syurecat/cansat-2024/README.md

[日本語](README.md) | [English](README.en.md)
# Koshi Science Team 2024

## ミッション
### スバル計画(Sub-aru計画)
缶サットにおける親機、子機、地上間の通信技術の確立

## 構成
- 'Visualization/': データの保存、可視化を担うwebアプリ
- 'arduino/': arduinoのプログラム
- 'twalite/': twaliteのプログラム
- 'docs/': システムのドキュメント

## 使用方法
各ディレクトリ下にあるREADMEに従ってセットアップ

## 使用機材

## 注意すべき仕様
- VisualizationのFirefoxへの対応することは今のところ考えていません。
