syurecat/cansat-2024/docs/CanSatNationalsPrePresentation.pdf

## 福井県立高志高等学校 物理部

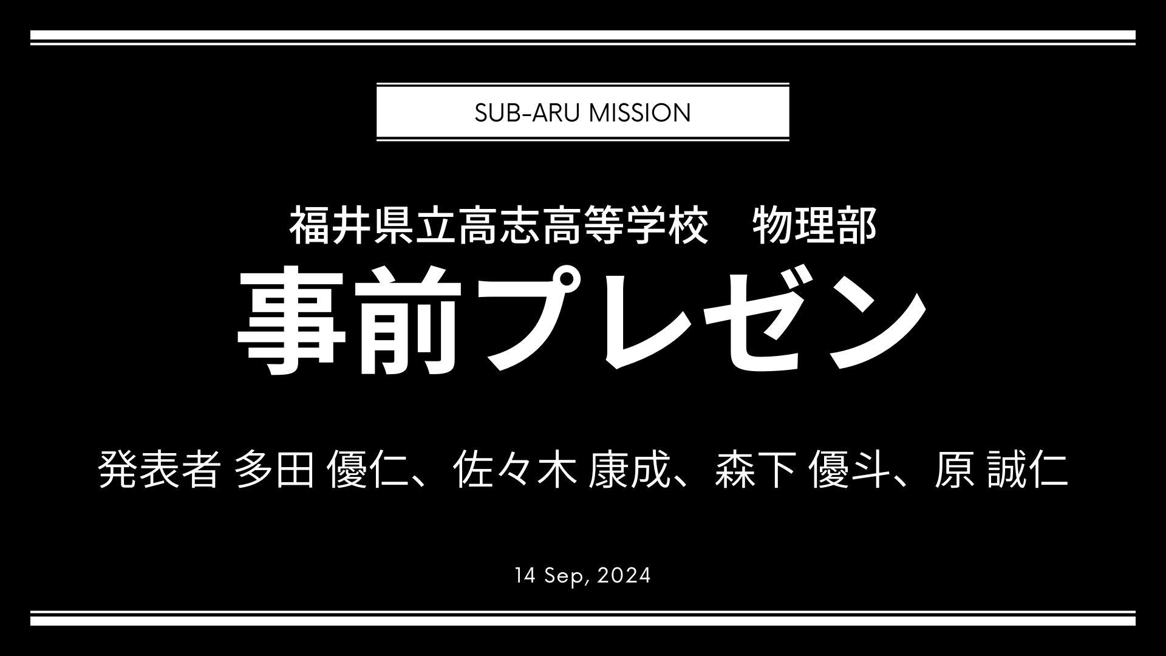
[picture p1: page 1]

福井県立高志高等学校　物理部

# 事前プレゼン

### 発表者 多田 優仁、佐々木 康成、 森下 優斗、原 誠仁

２０２４年度　缶サット福井県大会

目次

## 親機、子機、地上間の 通信技術の確立 情報のリアルタイム可視化

CONTENT 01 ミッション概要

CONTENT 01 ミッション概要
＊ミッションの目標

### 子機、親機、地上の双方向通信を確立する

# リアルタイムかつ高速に通信

### テレメトリデータの可視化

CONTENT 01 ミッション概要

＊ミッションの意義

１回収不可能なミッションにおいて通信は必須

２容量の大きなデータを送りやすい

３誰が見てもわかりやすく可視化できる

# 未知の惑星

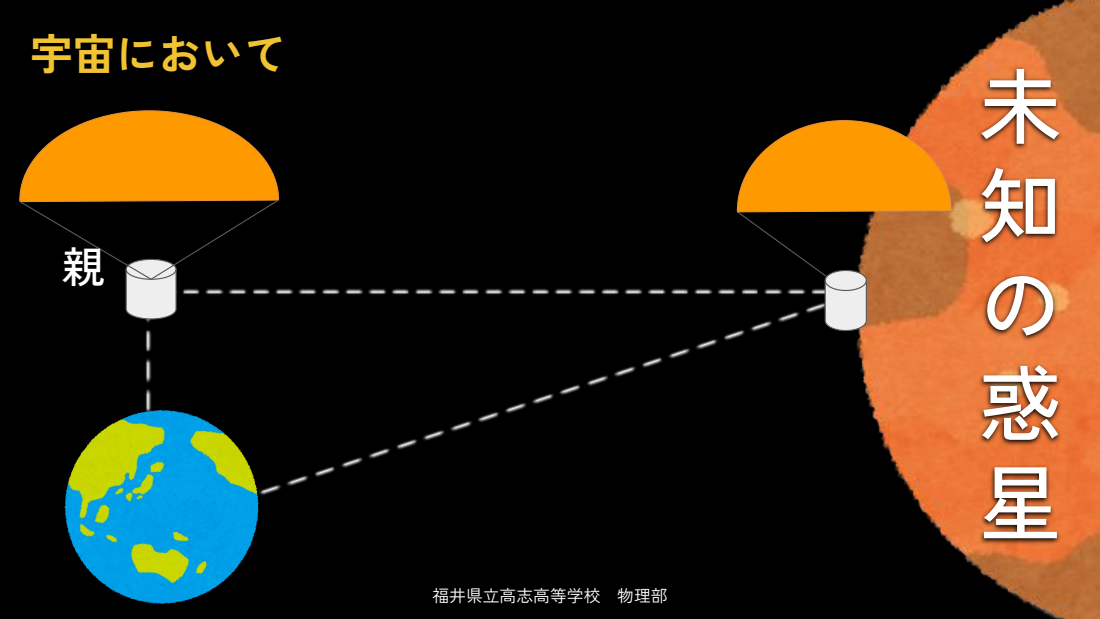
[picture p2: page 6]
宇宙において 親

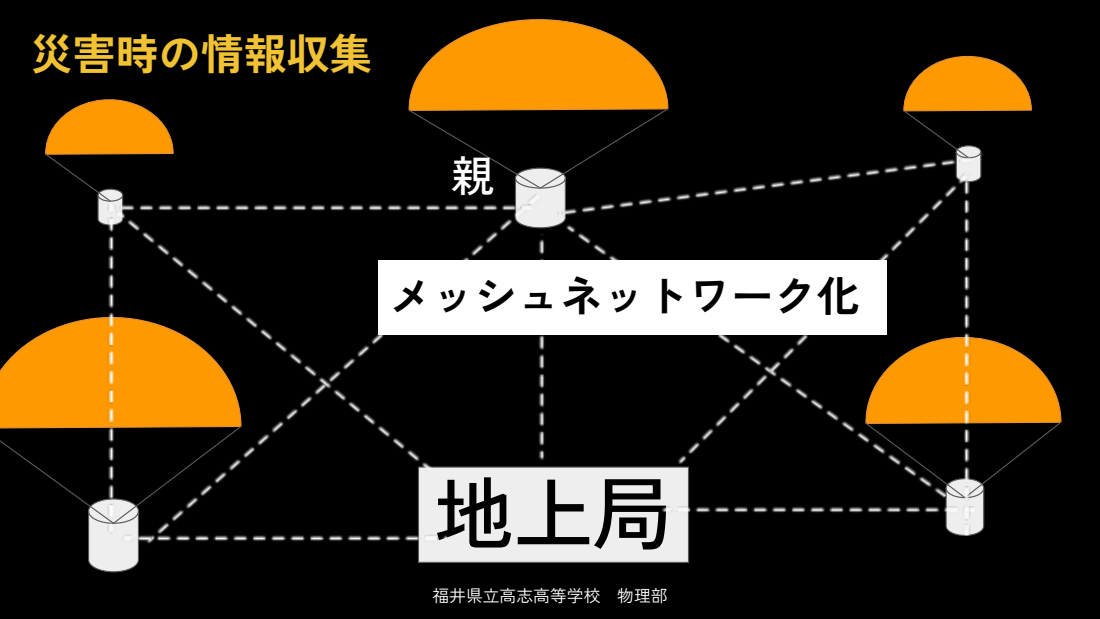
[picture p3: page 7]
地上局; 災害時の情報収集; メッシュネットワーク化

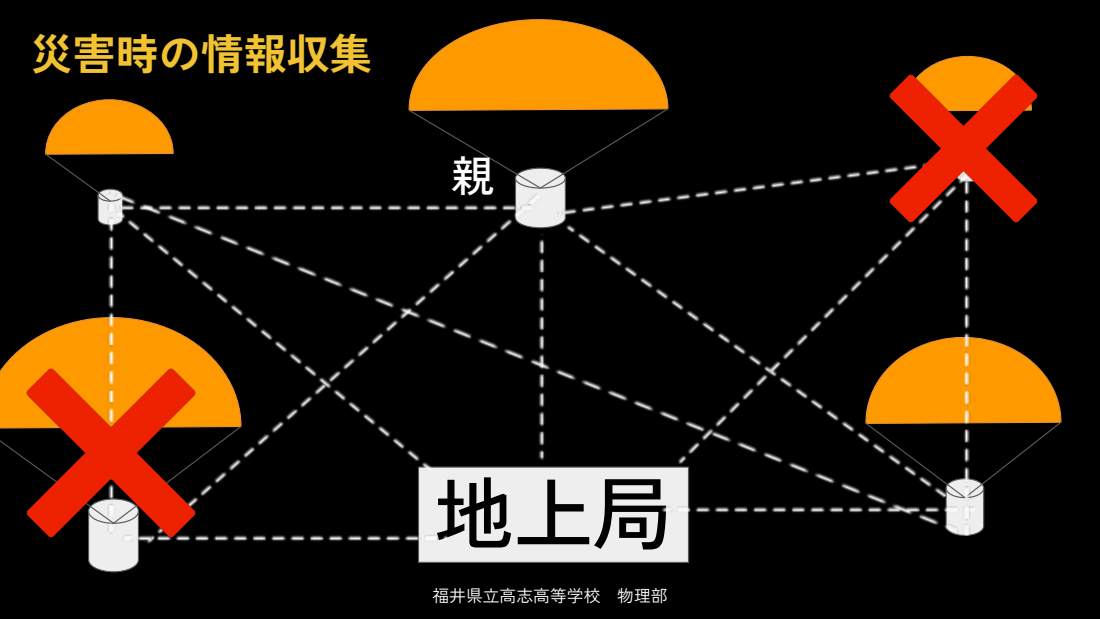
[picture p4: page 8]
地上局; 災害時の情報収集

情報をリアルタイムにグラフ化することによって...

１傾向、異常値の発見が早急にできる

２複雑なデータでも理解しやすい

３手順の統一化、効率化ができる

→原因分析、状況に応じた対応が取りやすい

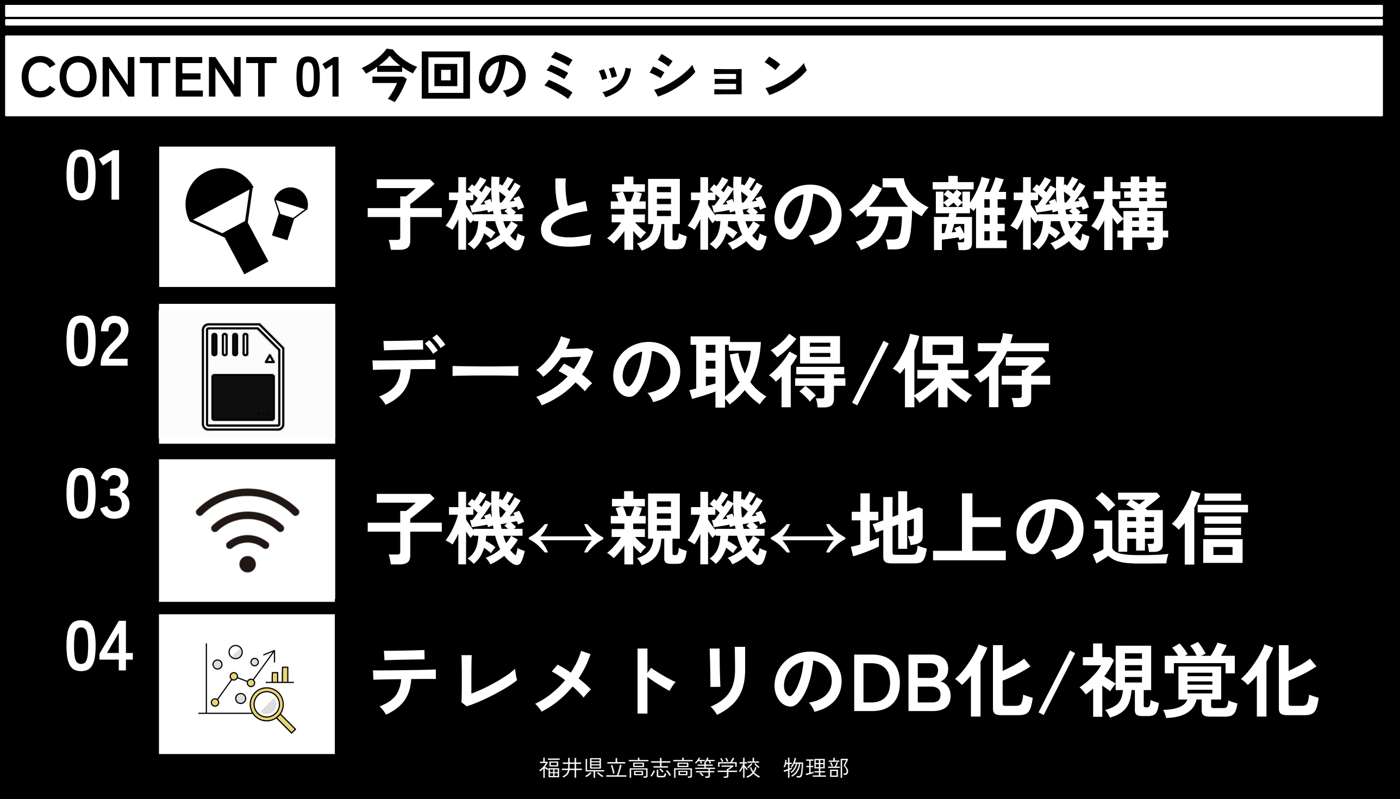
[picture p5: figure]
子機と親機の分離機構; データの取得/保存; 子機↔親機↔地上の通信 04 テレメトリのDB化/視覚化

CONTENT 01 ミッションに必要な3つの軸 CONTENT 01 今回のミッション

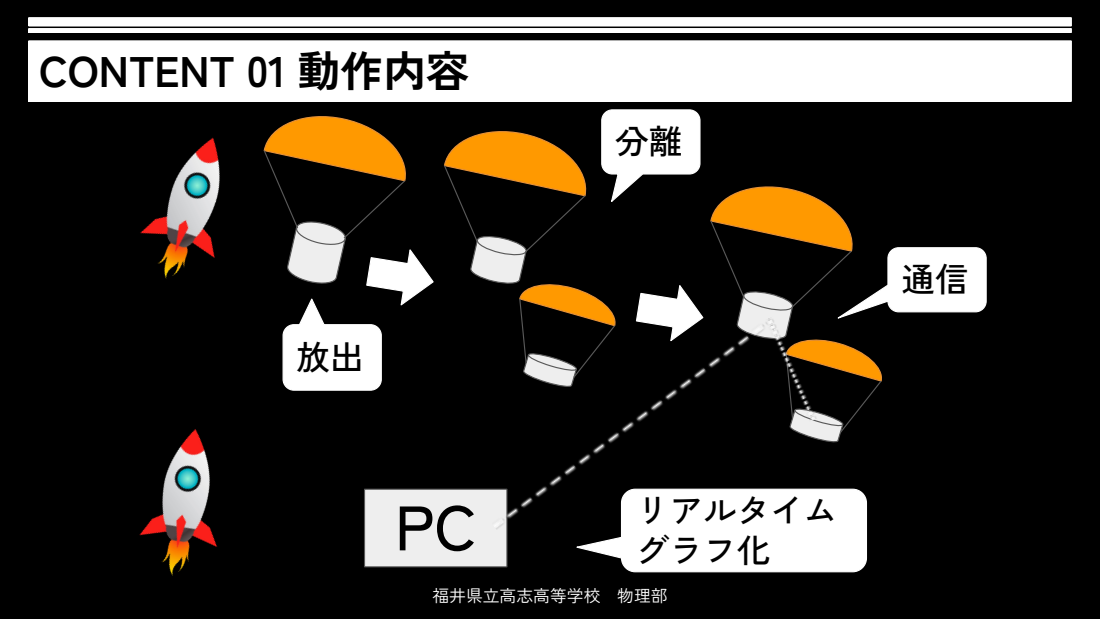
[picture p6: page 11]
リアルタイム; グラフ化

CONTENT 01 ミッションに必要な3つの軸 CONTENT 01 動作内容

CONTENT 01 ミッションに必要な3つの軸 CONTENT 缶サットの名称

# Sub-aru 計画

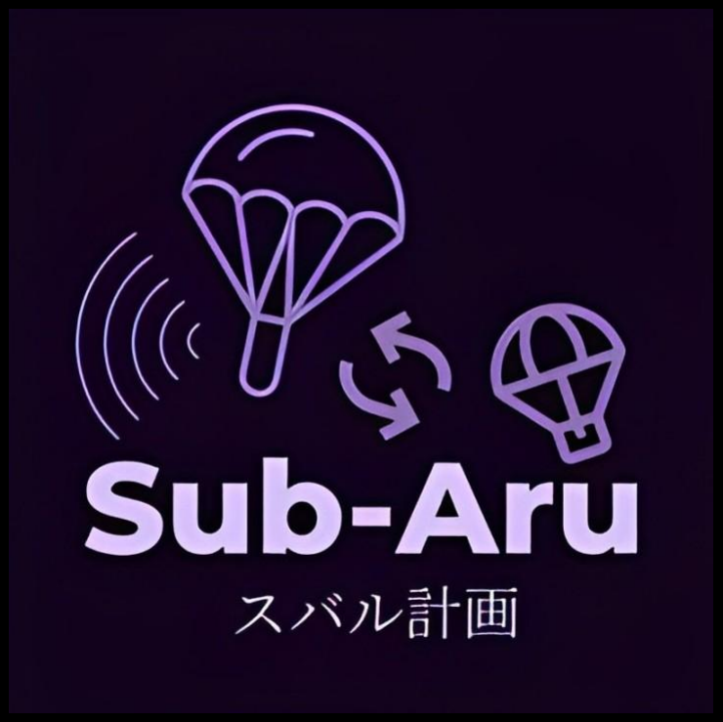
[picture p7: figure]

CONTENT 01 ミッションに必要な3つの軸 CONTENT 缶サットの名称

スバル 計画 | 機体　すばる君
| 親機　すばるマザー
| 子機　すばるキッズ

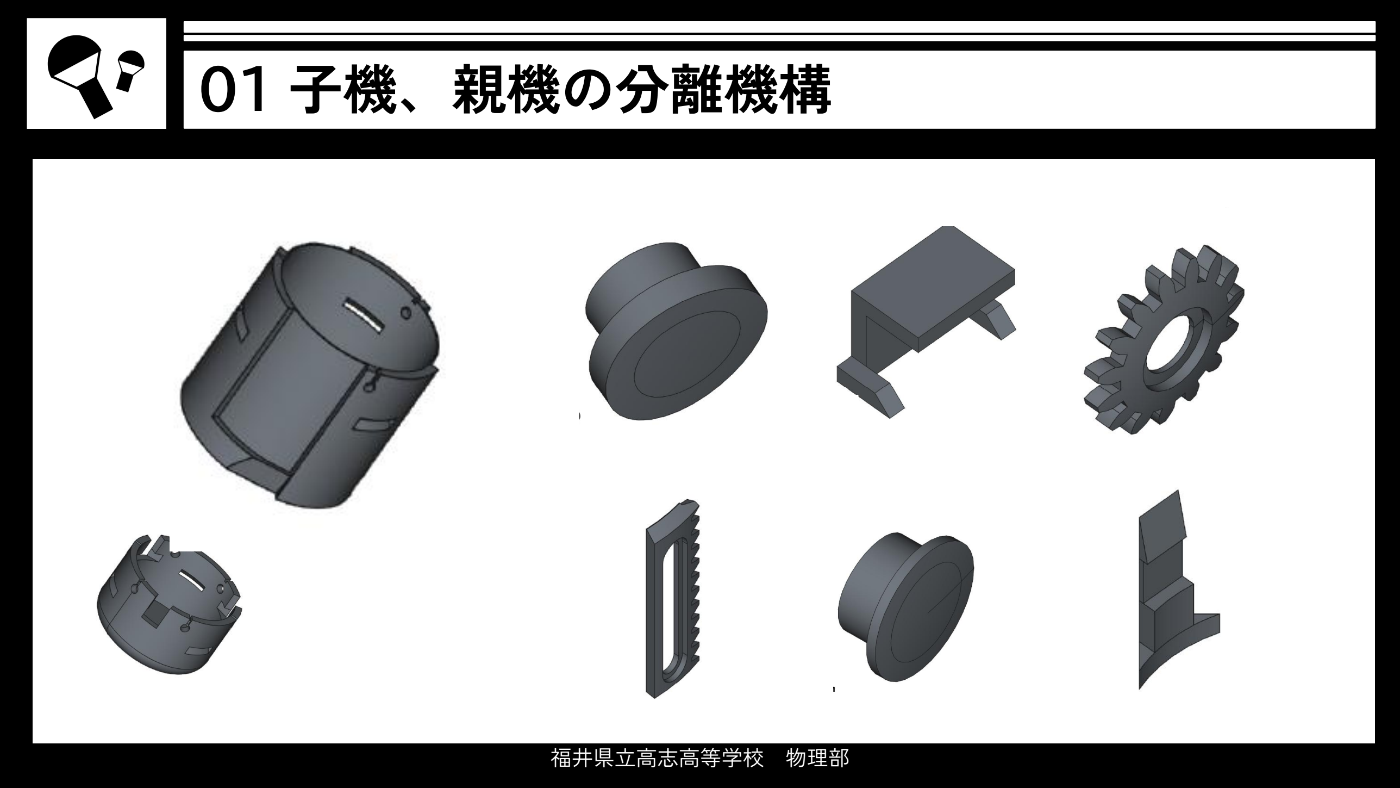
[picture p8: page 14]

CONTENT 01 ミッションに必要な3つの軸 01 子機、親機の分離機構

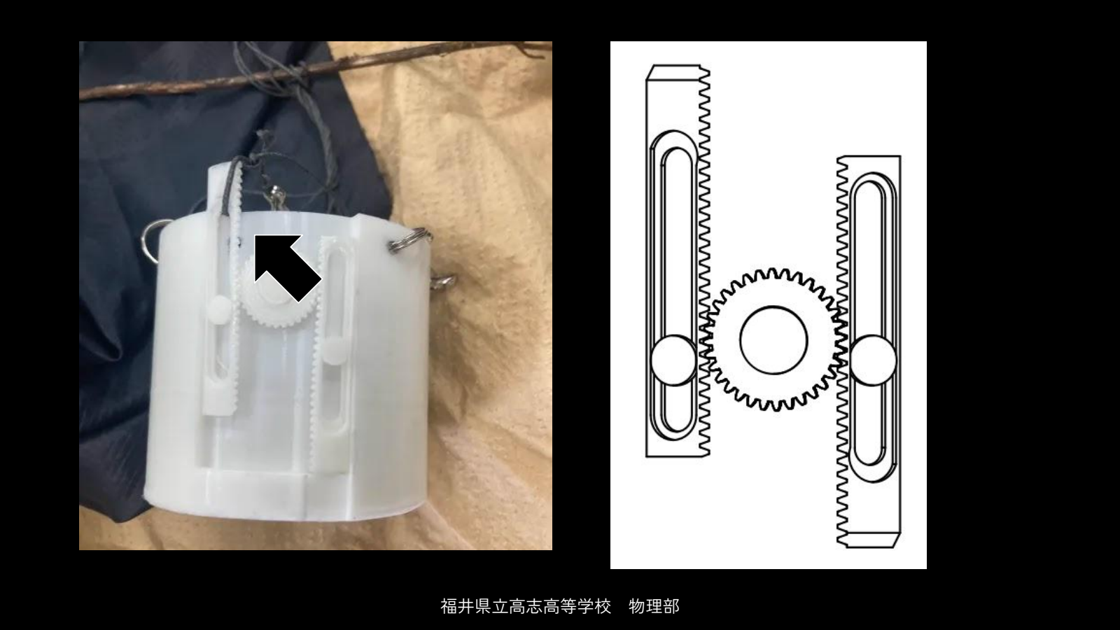
[picture p9: page 15]
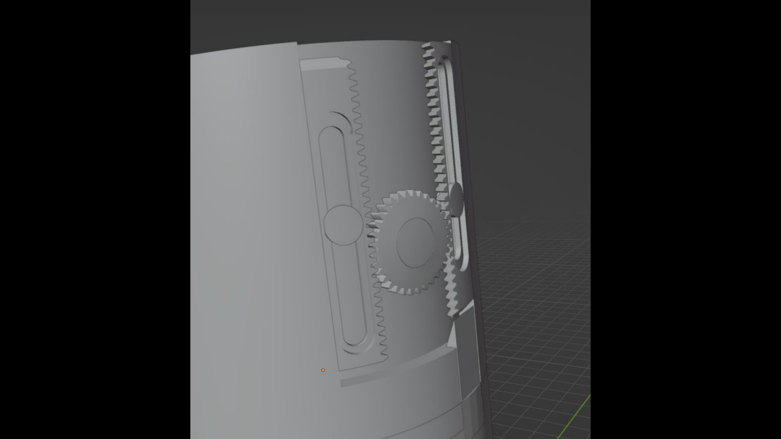
[picture p10: page 16]
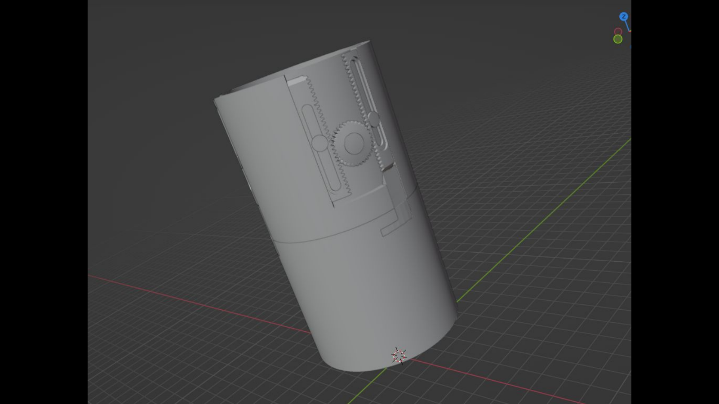
[picture p11: page 17]
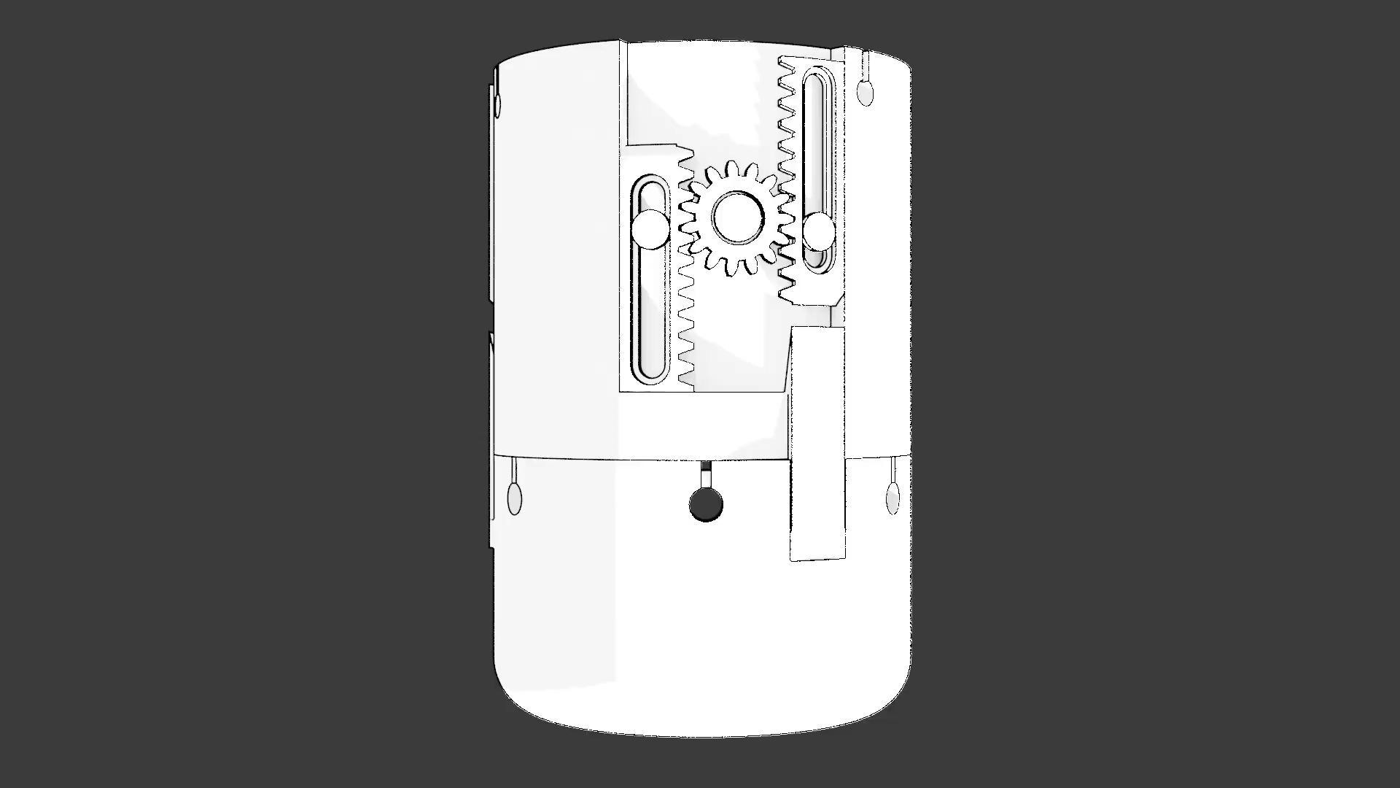
[picture p12: page 18]

CONTENT 01 ミッションに必要な3つの軸 02 HKデータの取得とSDへの保存 ＊今回収集するテレメトリについて

HKデータ(House Keeping data)

すばる君の機能性、健全性をモニタ

・通信強度
・加速度
・角速度
・地磁気
・高度
・位置

ミッションデータ

すばる君が収集するデータ

・気温
・湿度

CONTENT 01 ミッションに必要な3つの軸 02 データの取得とSDカードへの保存

すばる君の機能性や健全性をモニタ

・通信強度
・加速度
・角速度
・地磁気

・高度
・位置
・気温
・湿度
を取得

親機と子機を載せる

プリント基板の設計

省スペース化が必須

CONTENT 01 ミッションに必要な3つの軸 02 HKデータの取得とSDへの保存

＊本体の構造
すばるマザー（親機） | マイコン
| (Arduino Nano Every)
無線モジュール(TWELITE)
| 9軸IMU 気圧湿度温度計 GPS　 LED SDカード 分離検知スイッチ 9V電源

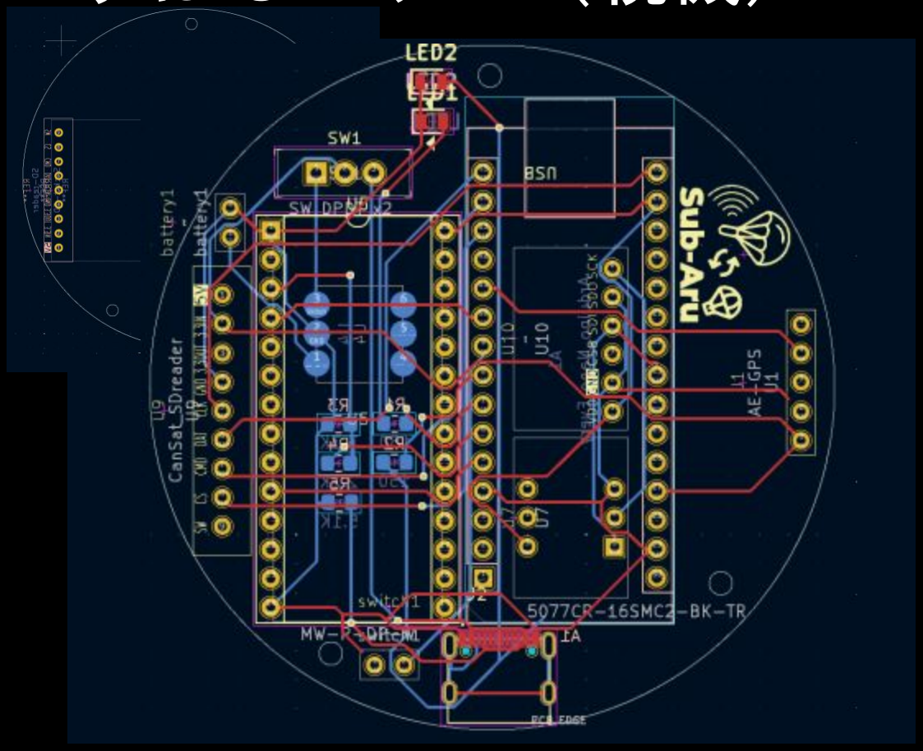
[picture p13: figure]

＊本体の構造
すばるキッズ（子機） | すばるマザー
| との通信のみを行う

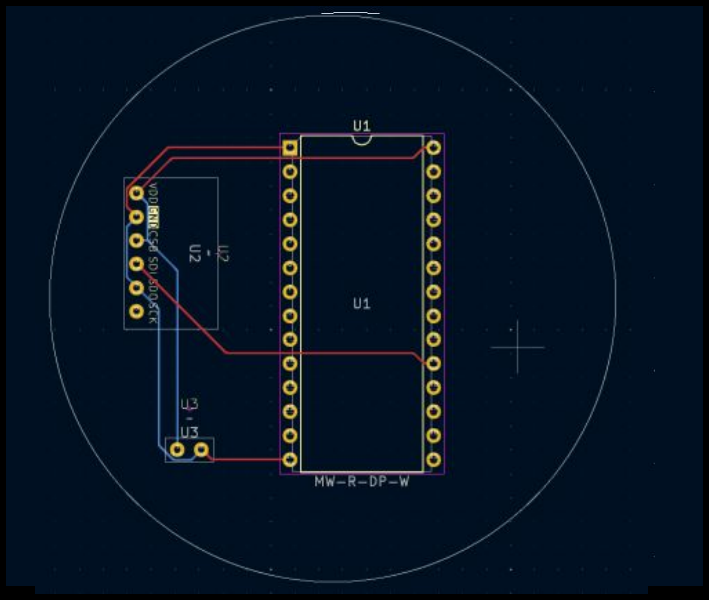
[picture p14: figure]

| 無線モジュール(TWELITE)
| 気圧湿度温度計
| Lipoバッテリー3.7V

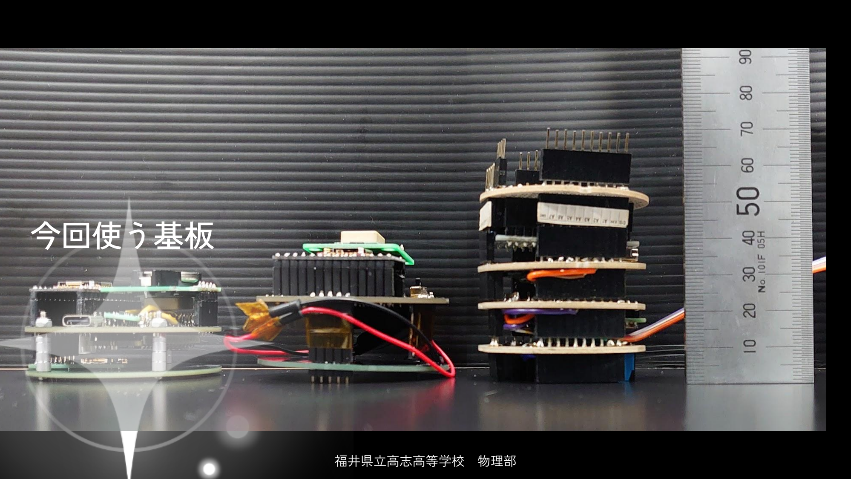
[picture p15: page 24]

一号機

二号機
今回使う基板

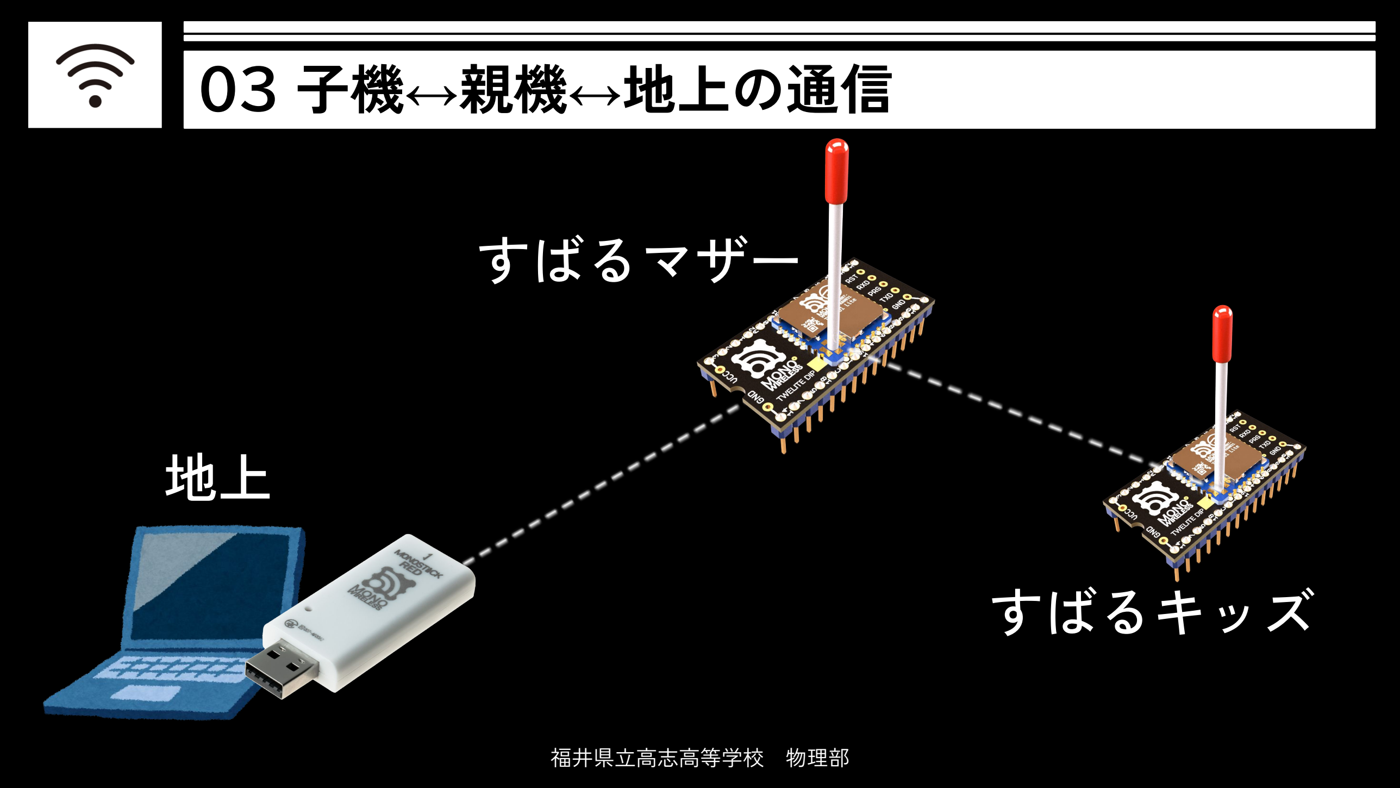
[picture p16: page 25]

すばるマザー

すばるキッズ

CONTENT 01 ミッションに必要な3つの軸 03 子機↔親機↔地上の通信

地上

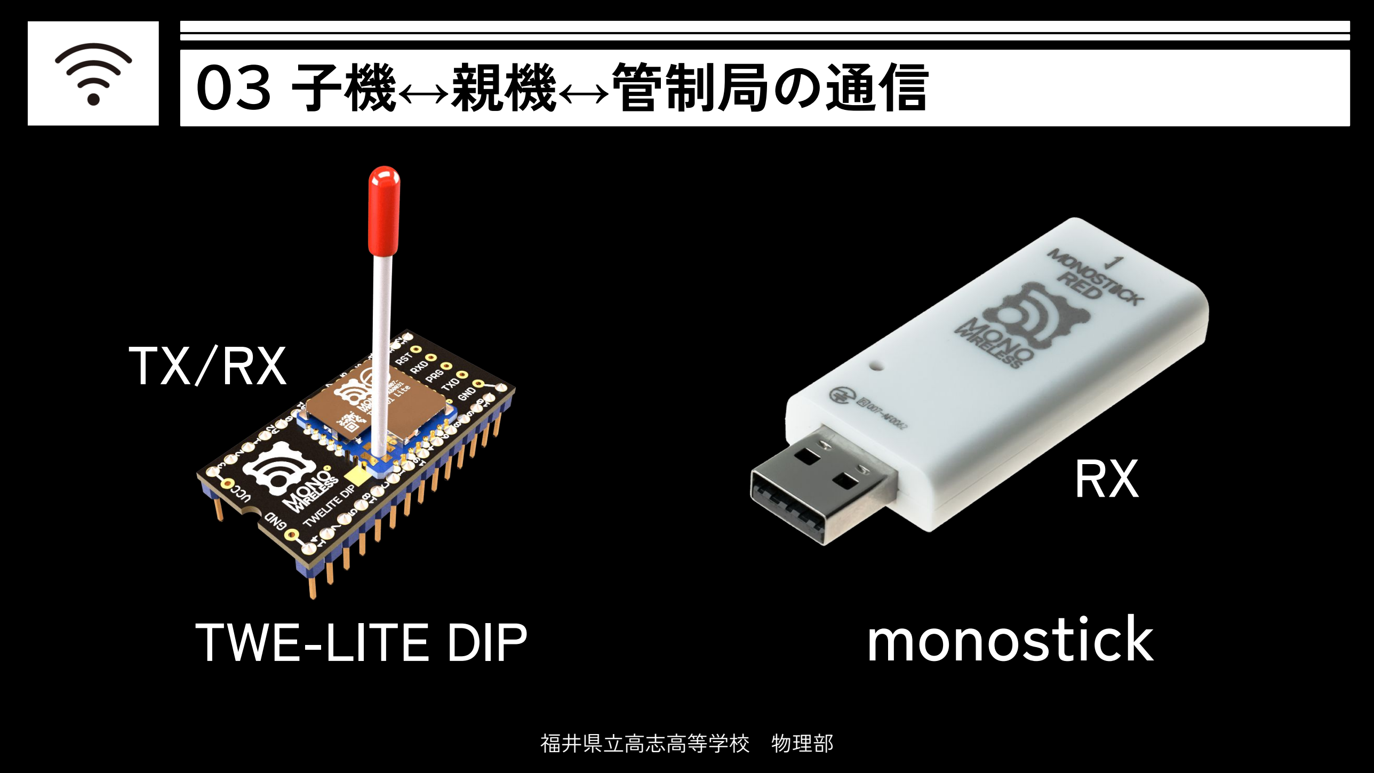
[picture p17: page 26]

CONTENT 01 ミッションに必要な3つの軸 03 子機↔親機↔管制局の通信

TWE-LITE DIP

TX/RX

### monostick

RX

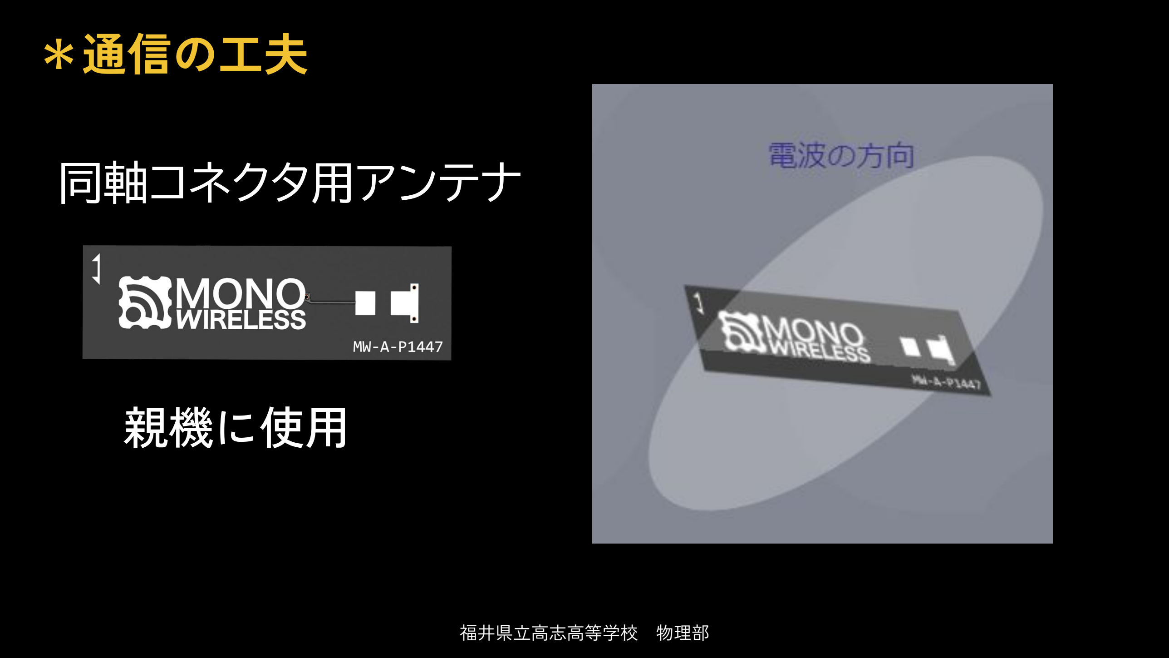
[picture p18: page 27]

＊通信の工夫

同軸コネクタ用アンテナ

親機に使用

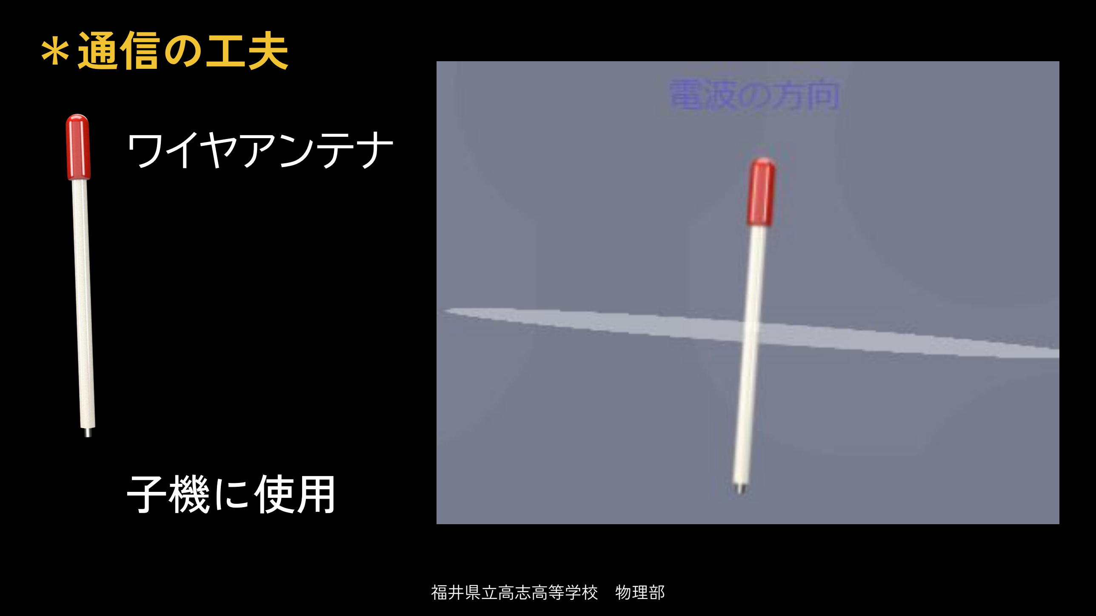
[picture p19: page 28]

＊通信の工夫

ワイヤアンテナ

子機に使用

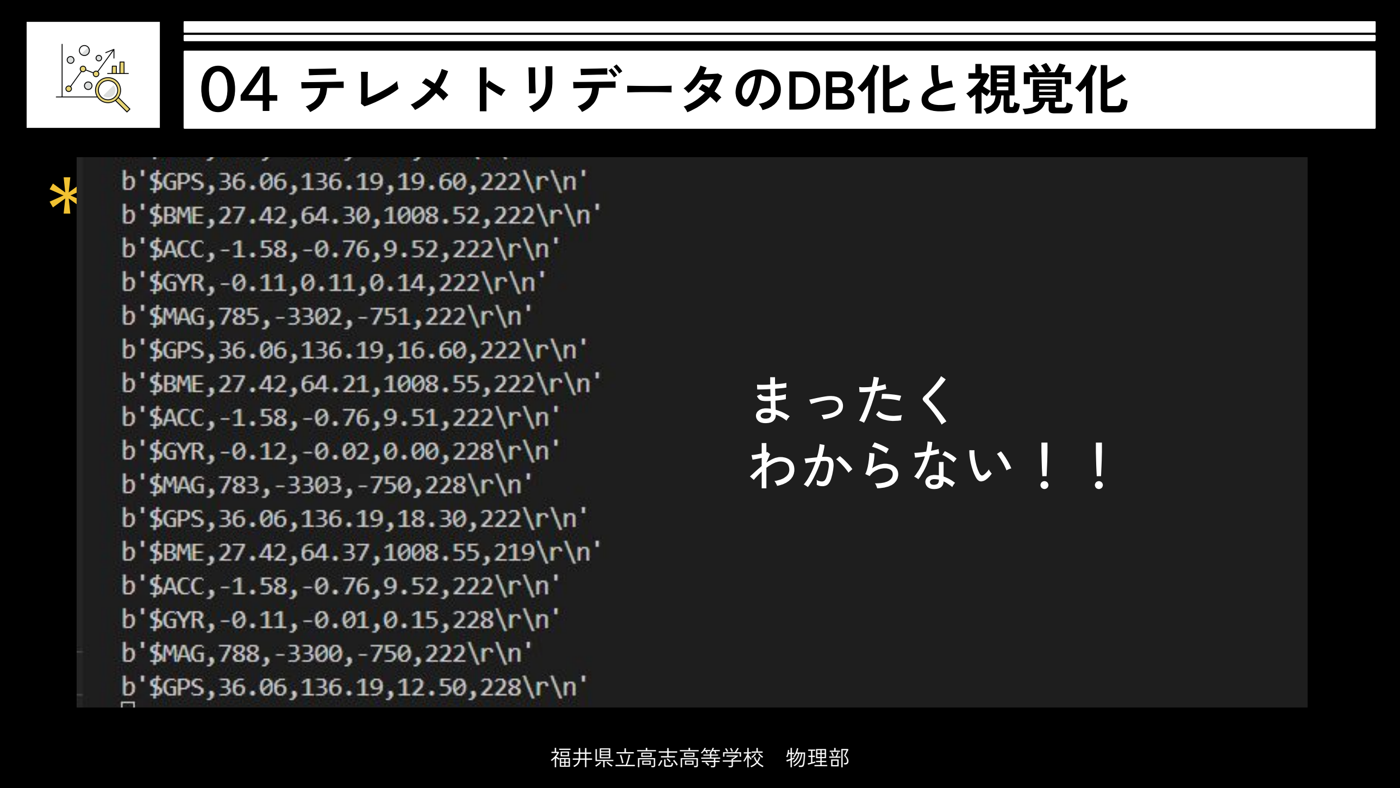
[picture p20: page 29]

CONTENT 01 ミッションに必要な3つの軸 0４ テレメトリデータのDB化と視覚化

＊システム構成

まったく
わからない！！

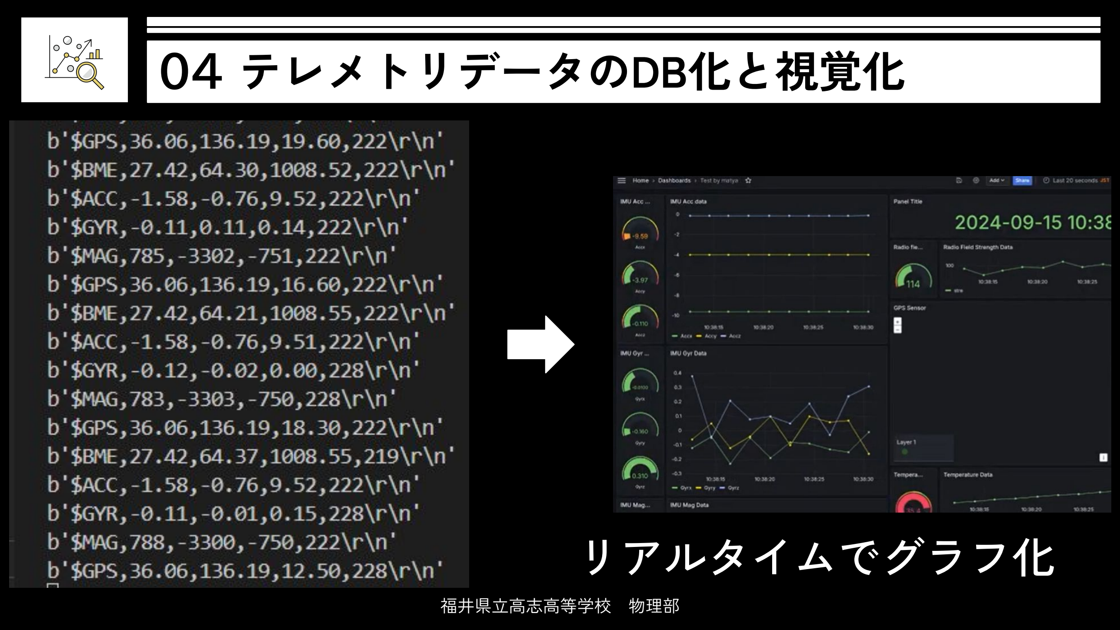
[picture p21: page 30]

CONTENT 01 ミッションに必要な3つの軸 0４ テレメトリデータのDB化と視覚化

リアルタイムでグラフ化

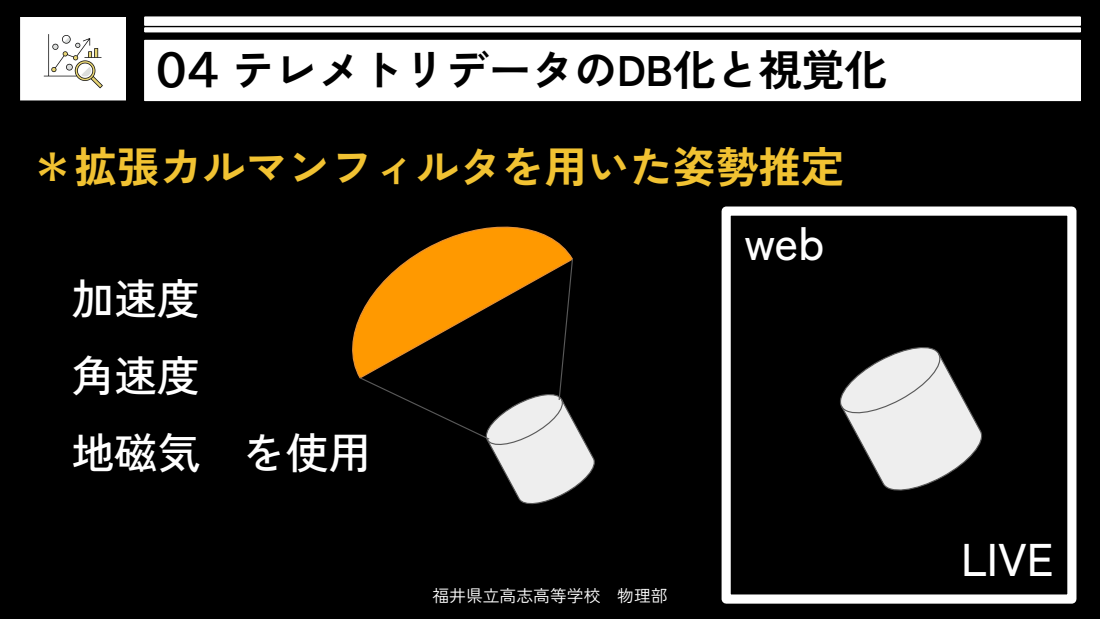
[picture p22: page 31]
CONTENT 01 ミッションに必要な3つの軸 0４ テレメトリデータのDB化と視覚化; ＊拡張カルマンフィルタを用いた姿勢推定; 加速度; 角速度; 地磁気 を使用; web; LIVE

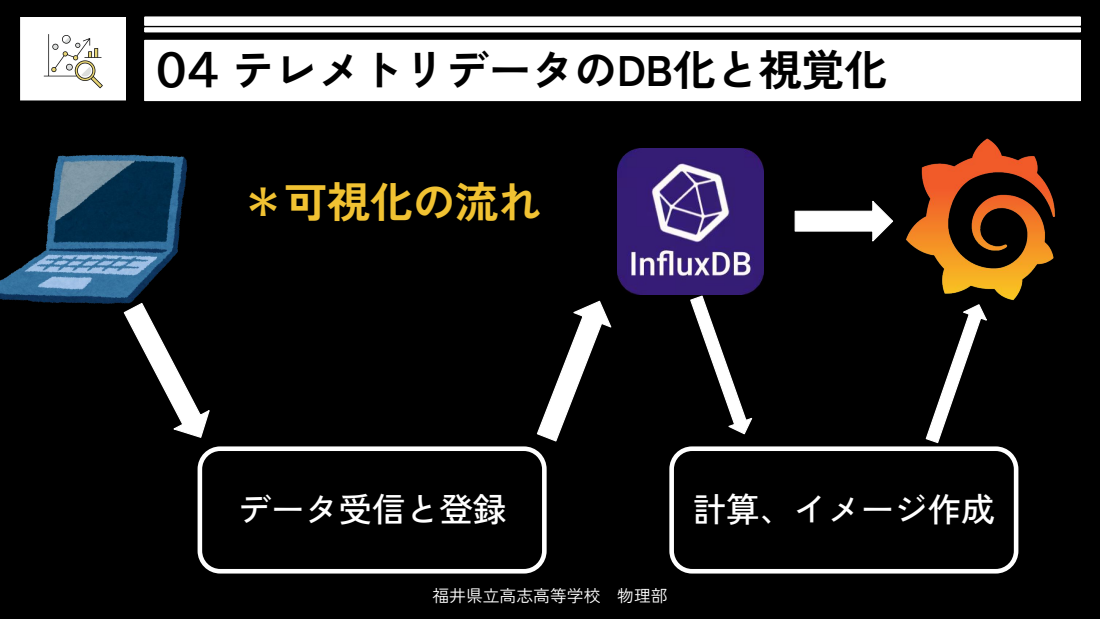
[picture p23: page 32]
データ受信と登録; 計算、イメージ作成; ＊可視化の流れ; CONTENT 01 ミッションに必要な3つの軸 0４ テレメトリデータのDB化と視覚化

CONTENT 01 ミッションに必要な3つの軸 CONTENT 0５　サクセスクライテリア　再掲

ミッション目標 | ミニマムサクセス | フルサクセス | エクストラサクセス
【構造目標】 子機、親機の分離 | レギュレーションに 沿った機構の作成 | 空中での分離 | 地上に落下しても壊 れない、何回も使える
【電子系目標１】 機体の正常動作 | センサすべてに電源 投入される | SDに保存される | N/A
【電子系目標２】 通信機構 | 地上での通信 | 親機↔管制局の通信 | 子機↔親機↔管制局 の通信
【ソフト系目標】 テレメトリのDB化, 視覚化 | DBの用意、 Dashboardの作成 | リアルタイムでDB化、 グラフ化 | データの抜けがない

CONTENT 00 あ

＊ミッションの目的・意義 ・学校の端、１８０ｍ、届く
水平方向
https://mono-wireless.com/jp/products/TWE-ANTENNAS/wire/index.html (https://mono-wireless.com/jp/products/TWE-ANTENNAS/wire/index.html)
ワイヤアンテナ

メモ

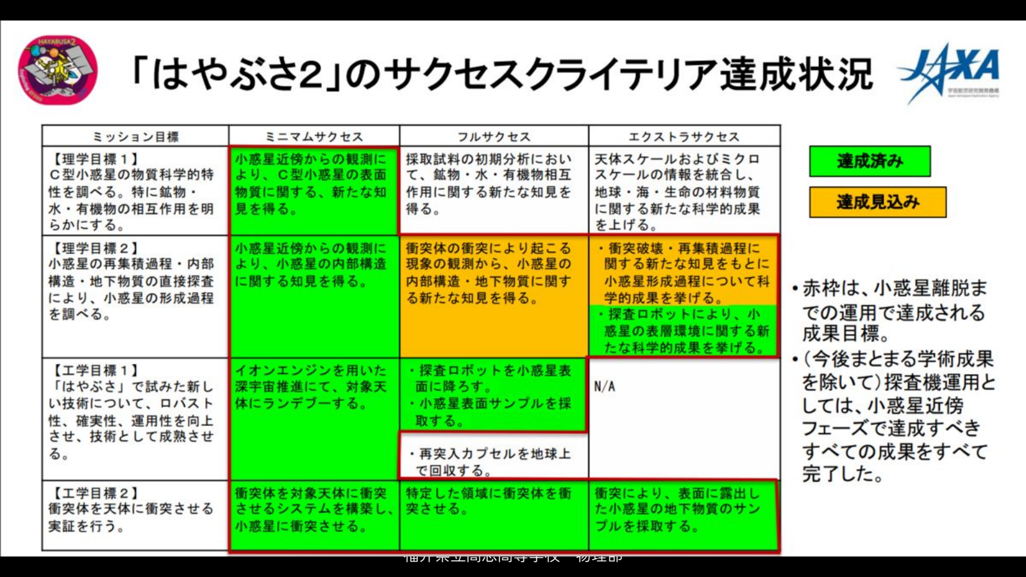
[picture p24: page 35]

CONTENT 00 あ

＊ミッションの目的・意義
