syurecat/cansat-2024/docs/EnglishPresentationSlides.pdf

## 福井県立高志高等学校 物理部

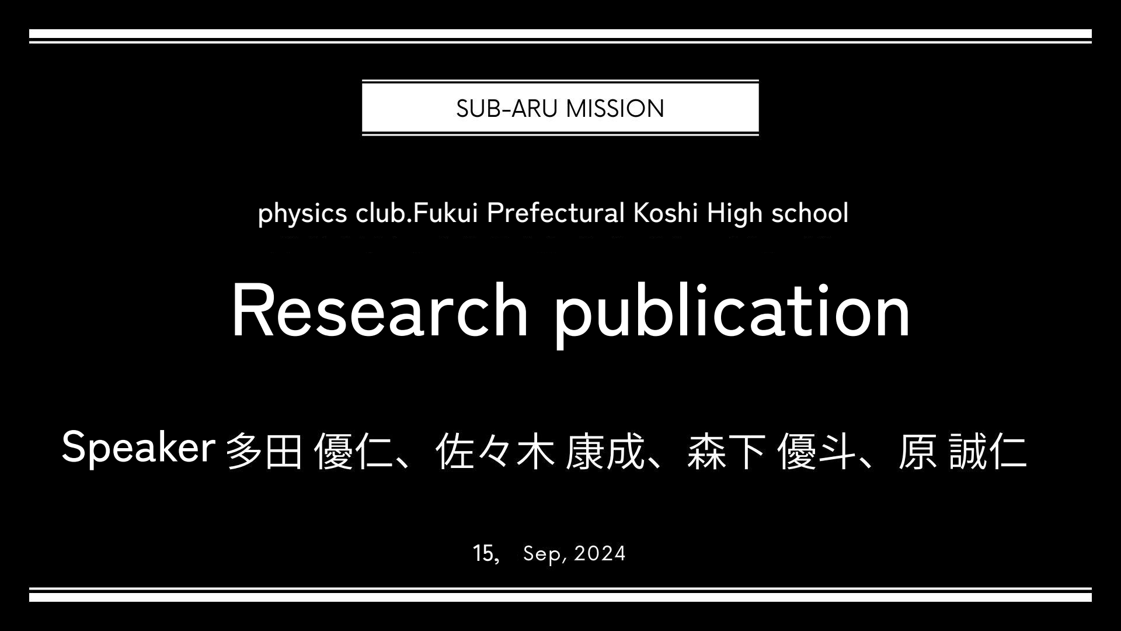
[picture p25: page 1]

Physics Club, Fukui Prefectural Koshi High School

# 事前プレゼン

### 発表者 多田 優仁、佐々木 康成、 森下 優斗、原 誠仁

２０２４年度　缶サット福井県大会

# Research publication

15,

physics club.Fukui Prefectural Koshi High school

Speaker

# what is cansat

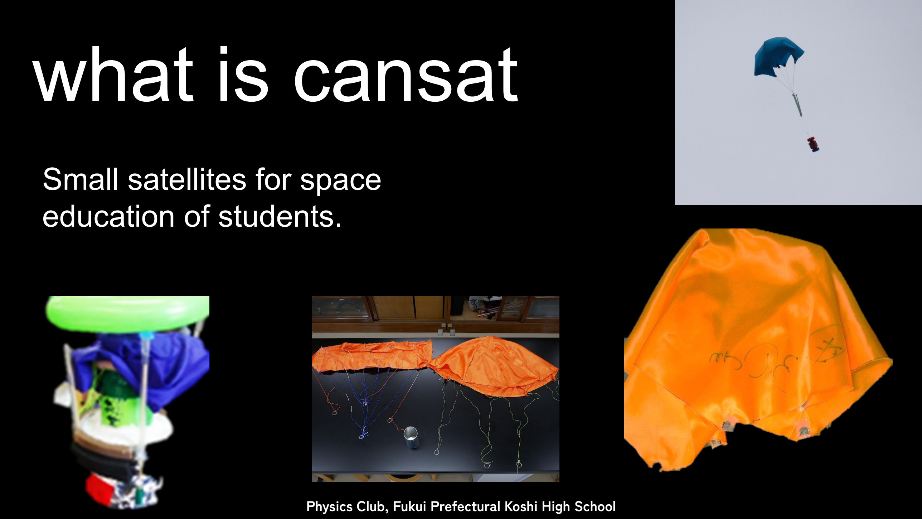
[picture p26: page 2]

Small satellites for space education of students.

### Commonalities with Satellites

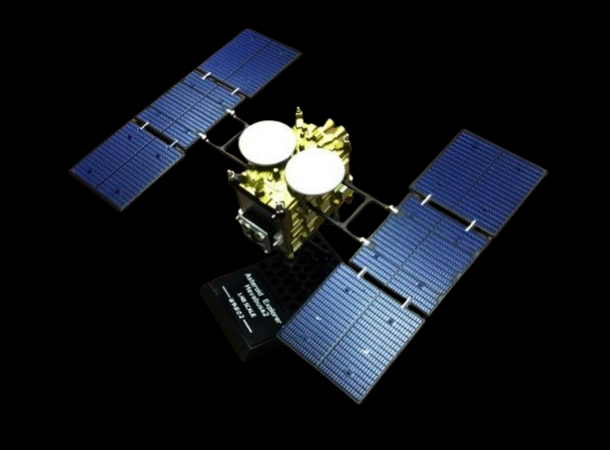
[picture p27: figure]

⬟sensors to understand its surroundings ・Camera
・GPS sensor
・IMU
etc…
⬟can move without being controlled directly by people ・wireless communication
・Micro computer
⬟It completes missions in limited space and with limited resources
・Electricity
・size
・structure
etc…

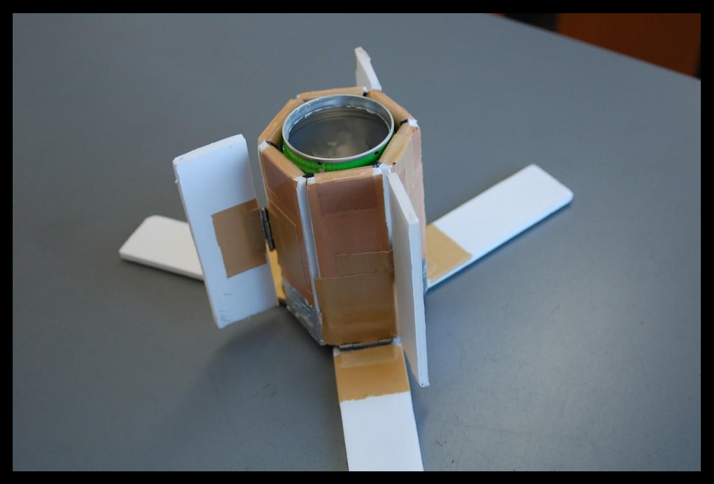
[picture p28: figure]

## Establish basic communication

technology between parent,

## child, and ground

CONTENT 01 Mission

CONTENT 01 Mission
＊ミッションの目的・意義

# Real-time and high-speed

### communication

# Visualization Telemetry

CONTENT 01 Mission

＊ミッションの目的・意義

１Communication is essential in missions where recovery is impossible.

２Makes it easier to send large data

３Clear and easy to understand for anyone.

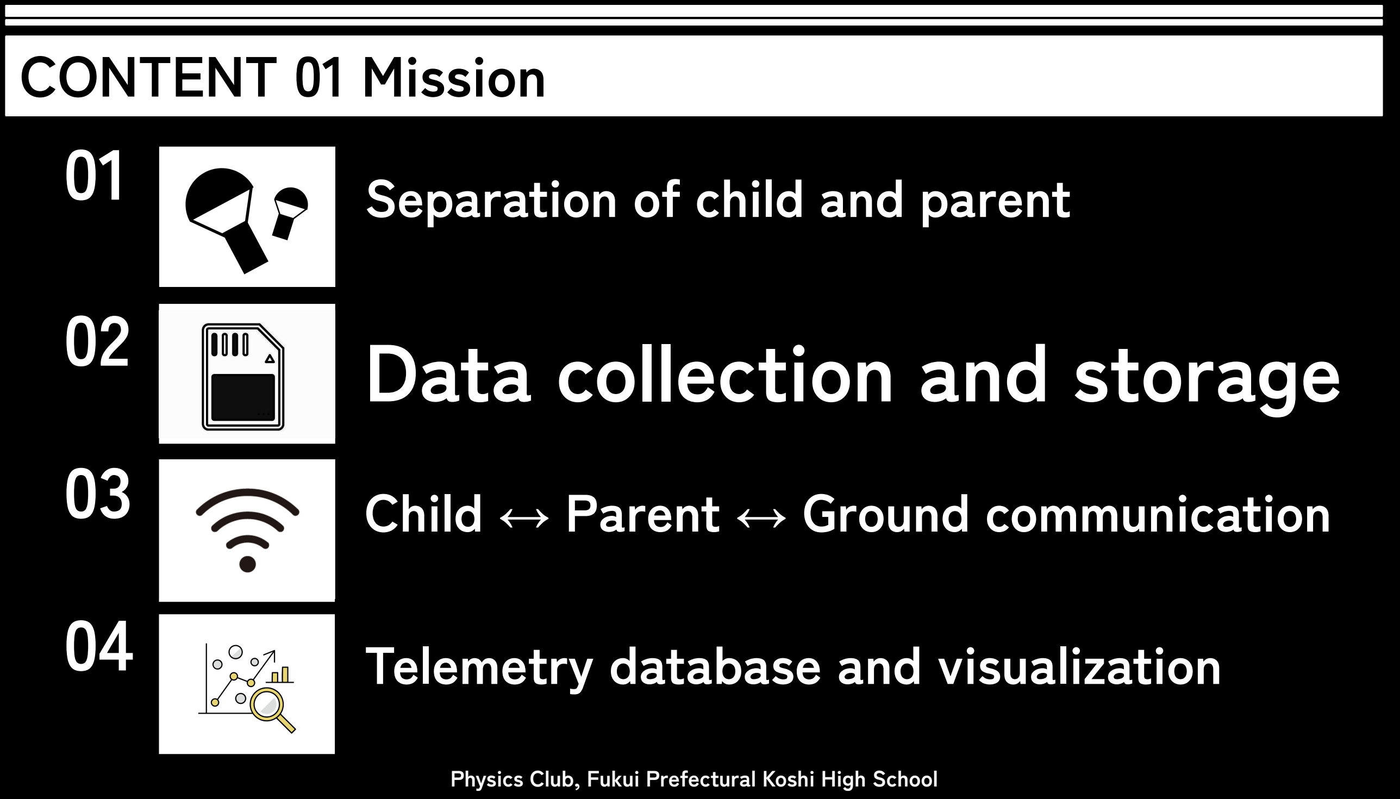
[picture p29: figure]
Separation of child and parent; Data collection and storage; Child ↔ Parent ↔ Ground communication; 04 Telemetry database and visualization

CONTENT 01 ミッションに必要な3つの軸 CONTENT 01 Mission

CONTENT 01 ミッションに必要な3つの軸 CONTENT Name of cansat

# Sub-aru 計画


CONTENT 01 ミッションに必要な3つの軸 CONTENT Name of cansat

スバル 計画 | 機体　すばる君
| 親機　すばるマザー 子機　すばるキッズ

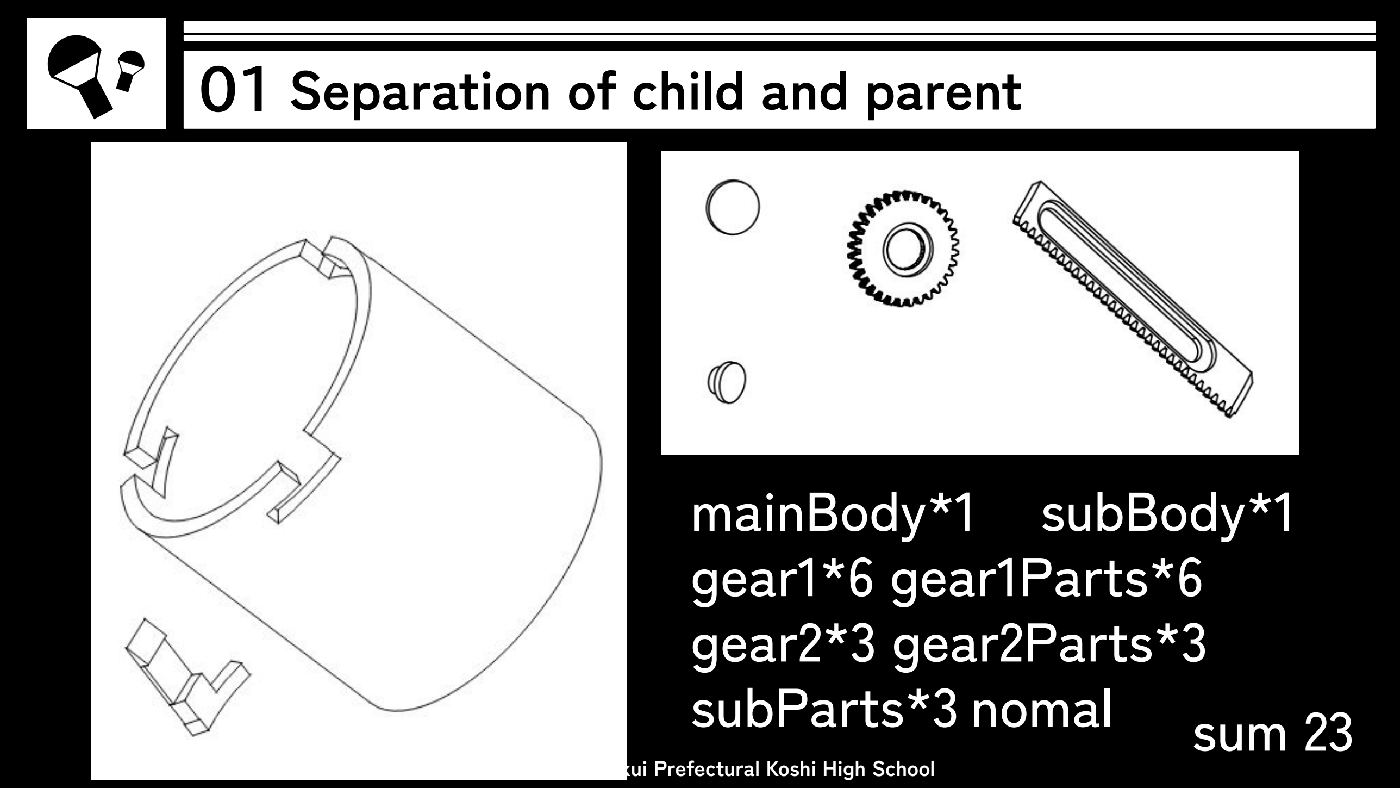
[picture p30: page 10]

CONTENT 01 ミッションに必要な3つの軸 01 Separation of child and parent

mainBody*1 subBody*1
gear1*6 gear1Parts*6
gear2*3 gear2Parts*3
subParts*3 nomal sum 23

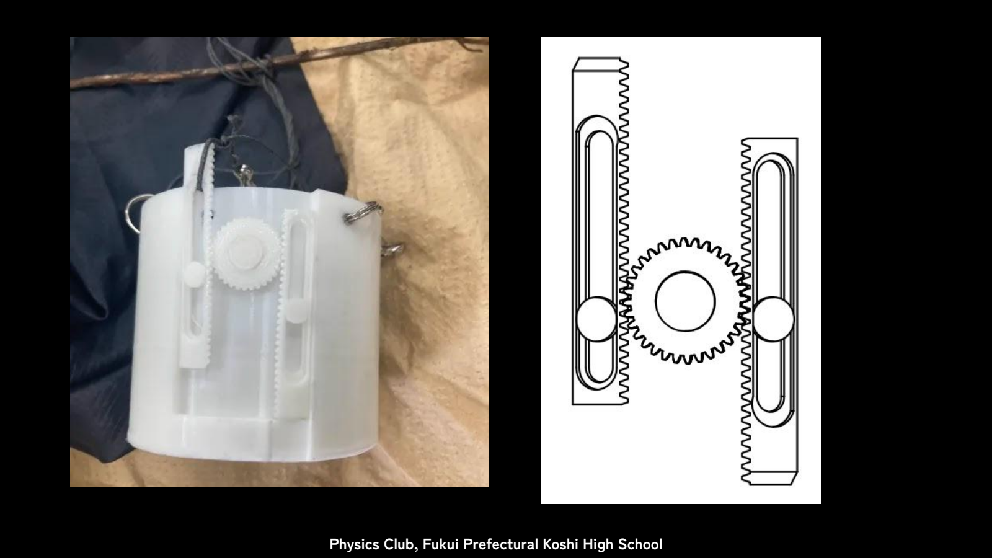
[picture p31: page 11]
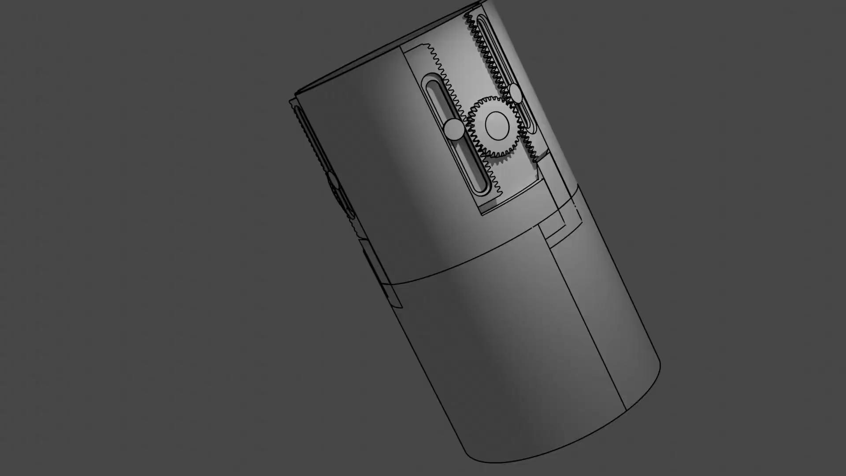
[picture p32: page 13]

CONTENT 01 ミッションに必要な3つの軸 02 Data collection and storage ＊About the telemetry we will collect this time

Housekeeping data

すばる君の機能性、健全性をモニタ

・Signal strength
・accelerometers
・gyroscopes
・magnetometers
・altitude
・position

Mission data

すばる君が収集するデータ

・temperature
・humidity

Load the parent and child

PCB Design

Space saving is essential

CONTENT 01 ミッションに必要な3つの軸 02 Data collection and storage

＊Advantages of PCB

Space-saving

Reduces soldering work
↓
Fewer soldering errors

Resistant to impact

Improves overall stability

＊本体の構造
すばるマザー（親機） | Arduino Nano Every

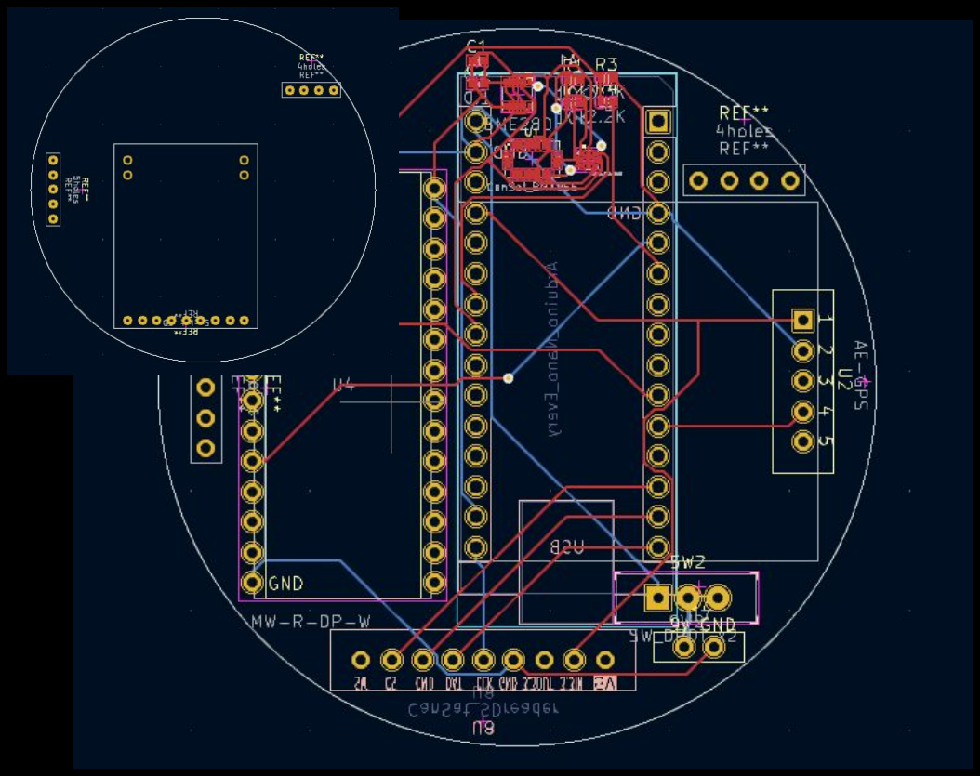
[picture p33: figure]

| TWELITE IMU 気圧湿度温度計 GPS SD
| Power

＊本体の構造
すばるキッズ（child） Focus on communication

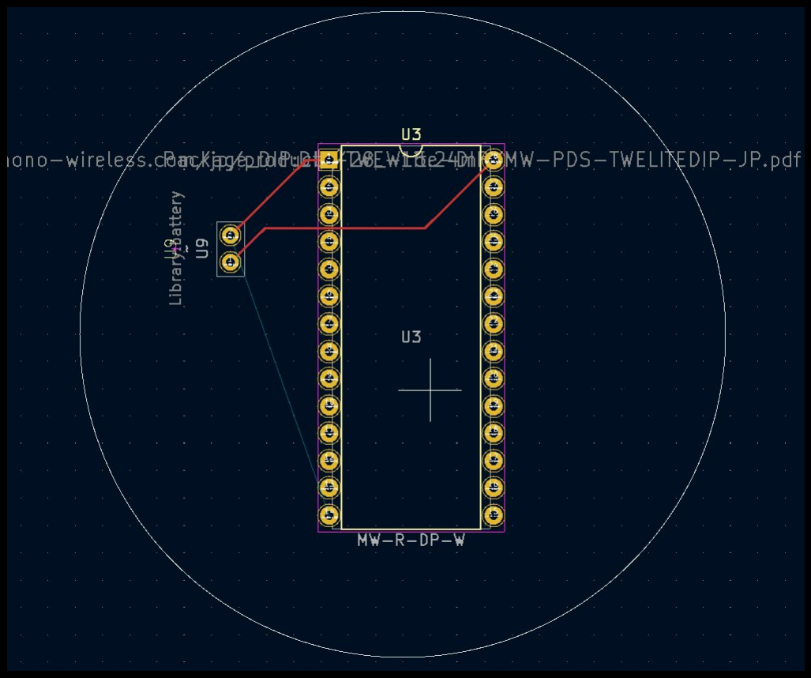
[picture p34: figure]

IMU
TWELITE

Lipo battery 3.7V

old ver.

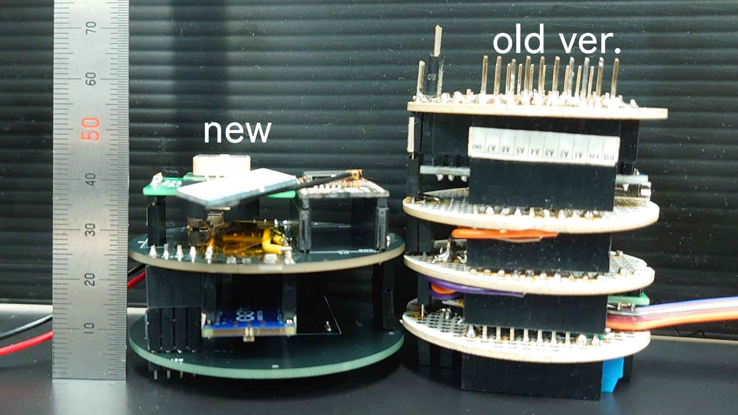
[picture p35: page 19]

従来型
新しく作成 new
ver.

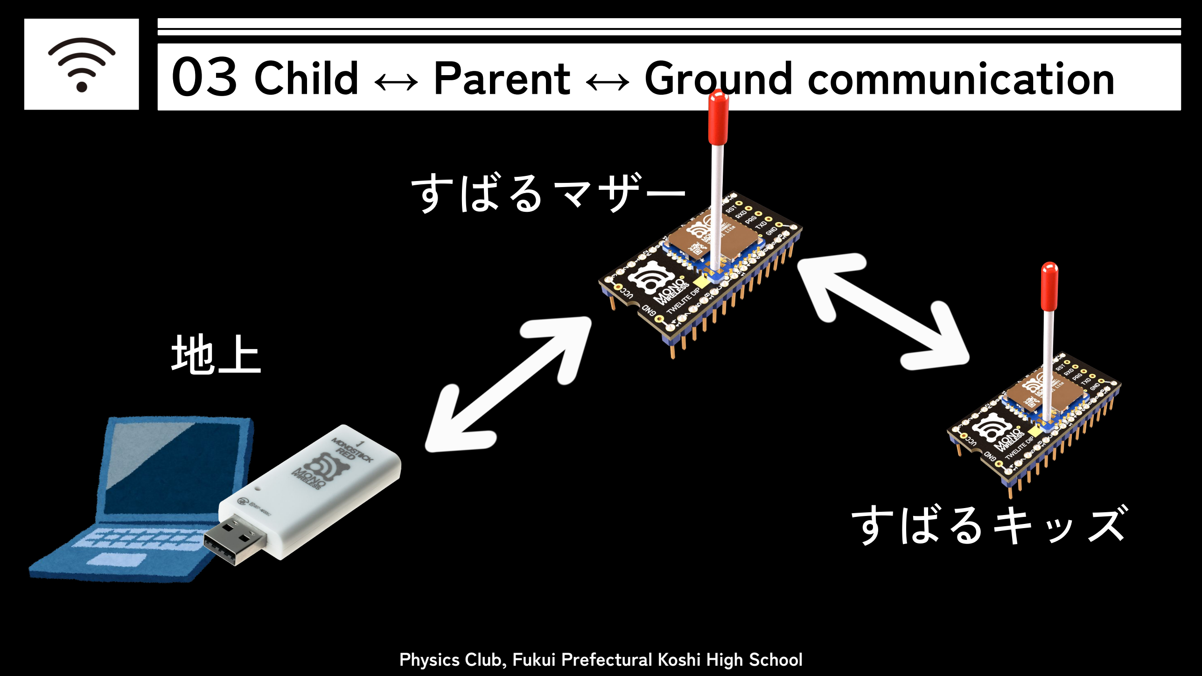
[picture p36: page 20]

すばるマザー

すばるキッズ

CONTENT 01 ミッションに必要な3つの軸 03 Child ↔ Parent ↔ Ground communication

地上

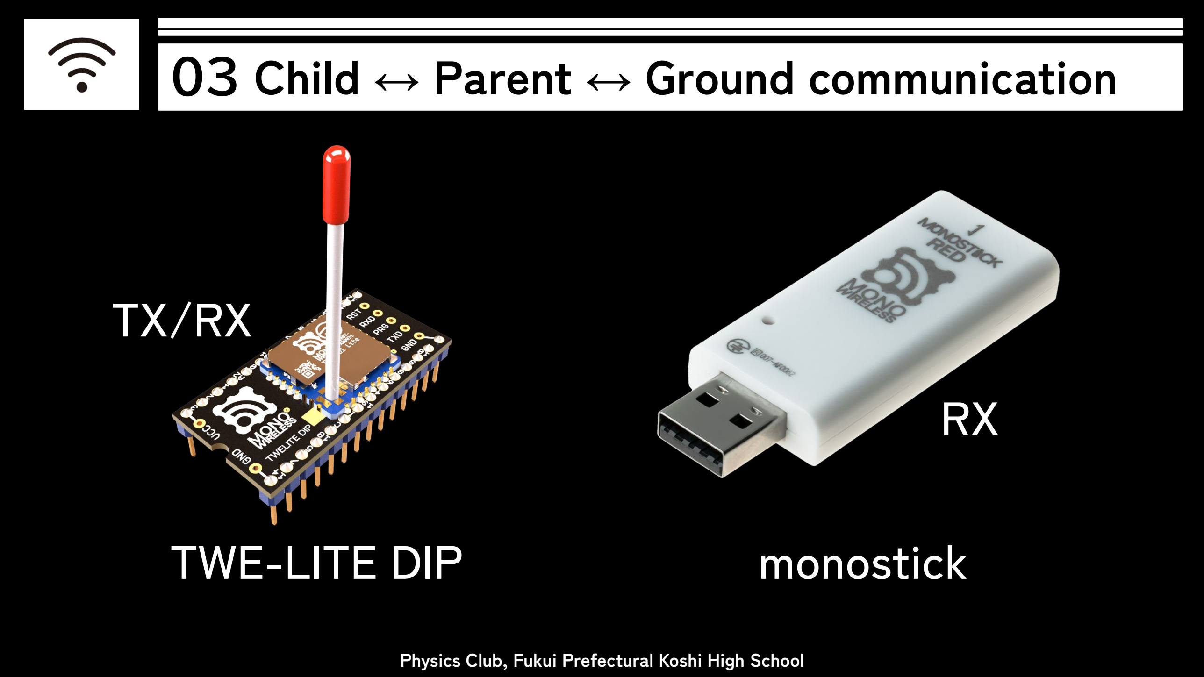
[picture p37: page 21]

CONTENT 01 ミッションに必要な3つの軸 03 Child ↔ Parent ↔ Ground communication

TWE-LITE DIP

TX/RX

monostick

RX

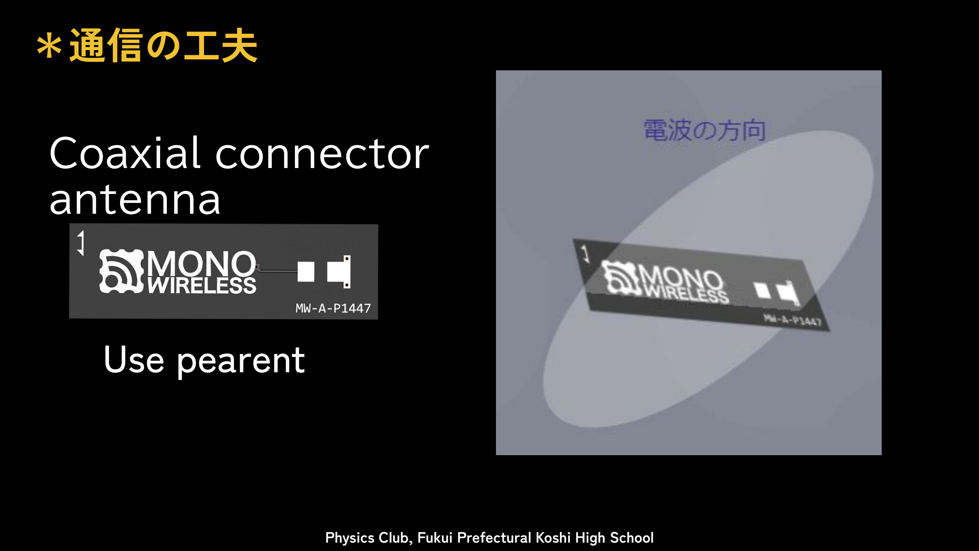
[picture p38: page 22]

＊通信の工夫

Coaxial connector
antenna

Use pearent

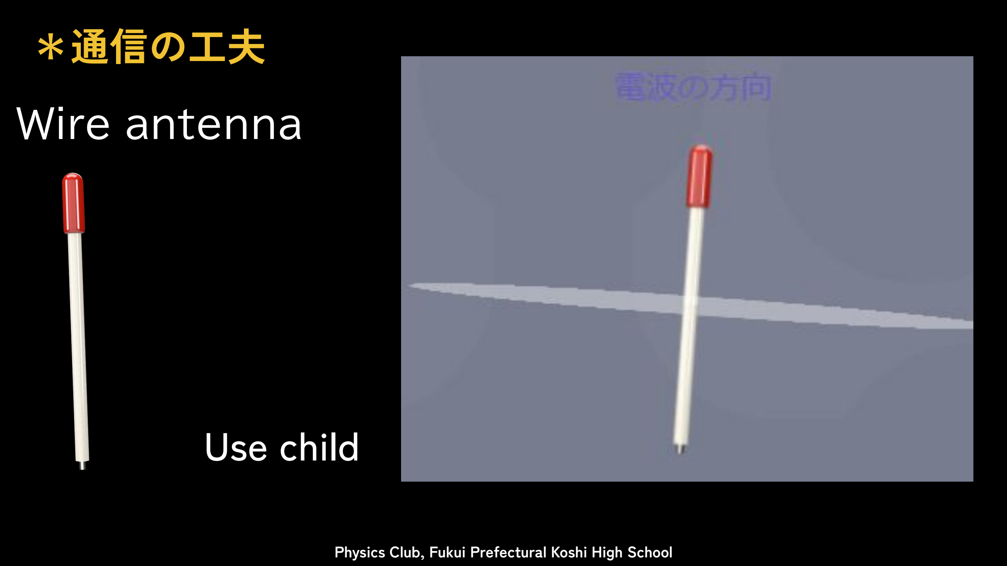
[picture p39: page 23]

＊通信の工夫

Wire antenna

Use child

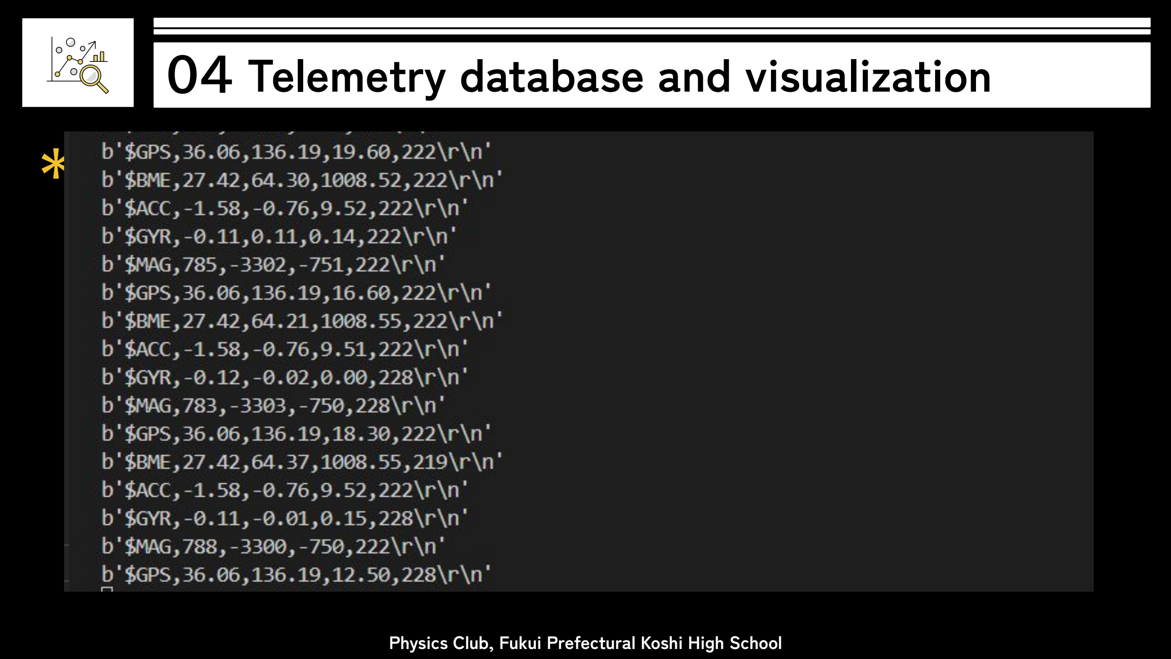
[picture p40: page 24]

CONTENT 01 ミッションに必要な3つの軸 0４ Telemetry database and visualization

＊システム構成

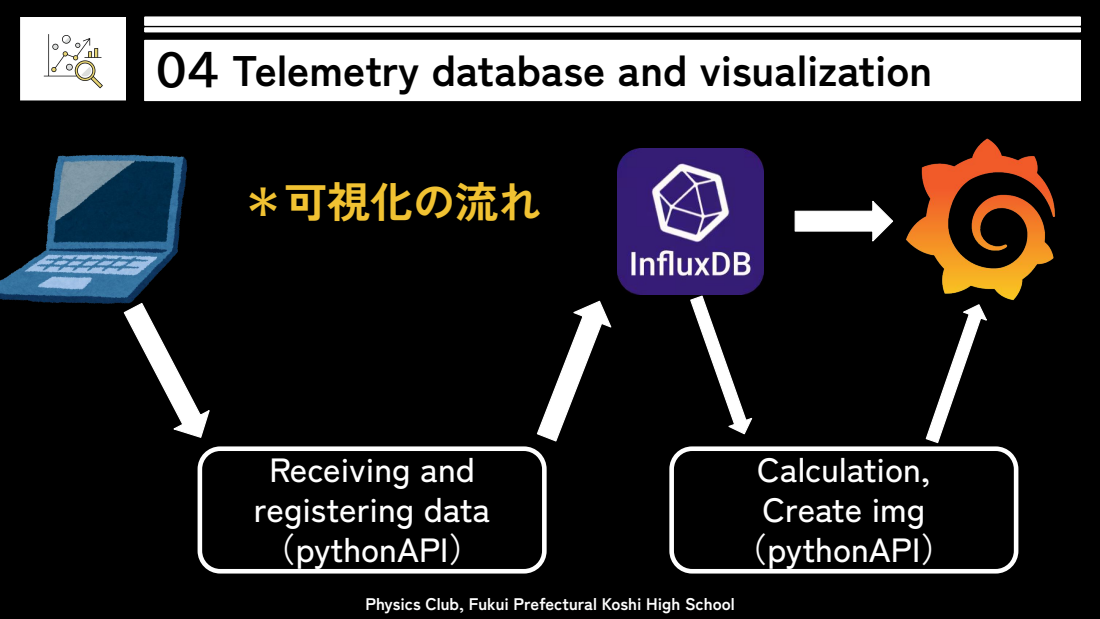
[picture p41: page 25]
Receiving and registering data （pythonAPI）; Calculation, Create img （pythonAPI）; ＊可視化の流れ

CONTENT 01 ミッションに必要な3つの軸 0４ Telemetry database and visualization

CONTENT 01 ミッションに必要な3つの軸 CONTENT 04 Success criteria

Mission | Min　Success | Full Success | Ex Success
【Structural】 Separate units | Build according to regulations | Air separation | Survive falls, reusable
【Electronics １】 Collect data | Power to all sensors | Save to SD | N/A
【Electronics ２】 communication | Ground communication | Parent ↔ Ground | Child ↔ Parent ↔ Ground
【Software】 Telemetry DB & visualization | Prepare DB, create dashboard | Local telemetry DB & visualization | Real-time DB & visualization

CONTENT 01 ミッションに必要な3つの軸 CONTENT Fukui Regional Convention

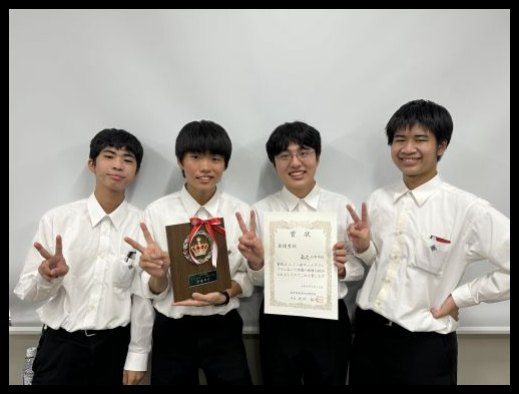
[picture p42: figure]
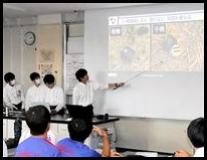
[picture p43: figure]
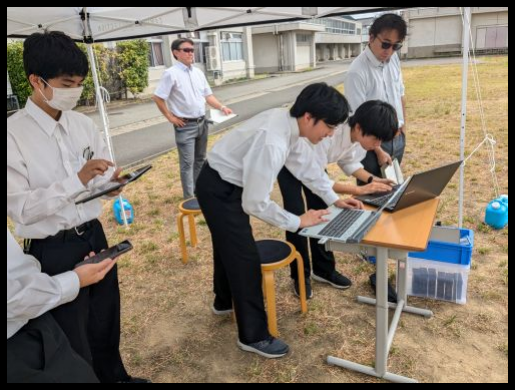
[picture p44: figure]

These are the results from when we participated in the Fukui regional competition of the CanSat
| Koshien. We received the top award and are set to
compete in the national competition

Mission | Min　Success | Full Success | Ex Success
【Structural】 Separate units | Build according to regulations | Air separation | Survive falls, reusable
【Electronics １】 Collect data | Power to all sensors | Save to SD | N/A
【Electronics ２】 communication | Ground communication | Parent ↔ Ground | Child ↔ Parent ↔ Ground
【Software】 Telemetry DB & visualization | Prepare DB, create dashboard | Local telemetry DB & visualization | Real-time DB & visualization
successfull | promising

親機 | 子機

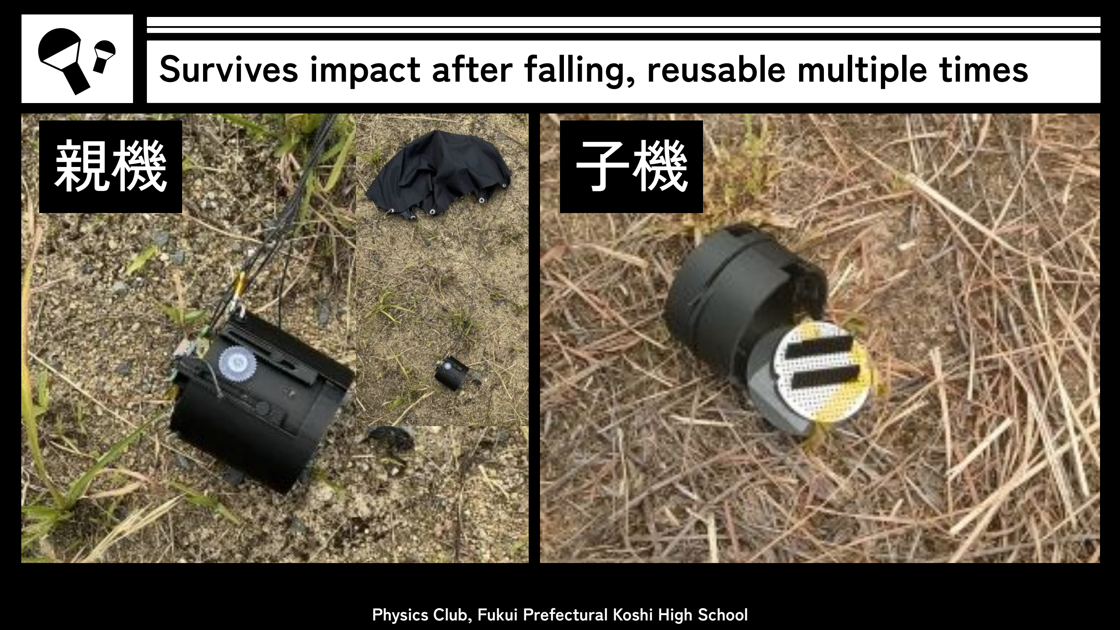
[picture p45: page 29]

CONTENT 01 ミッションに必要な3つの軸 Survives impact after falling, reusable multiple times

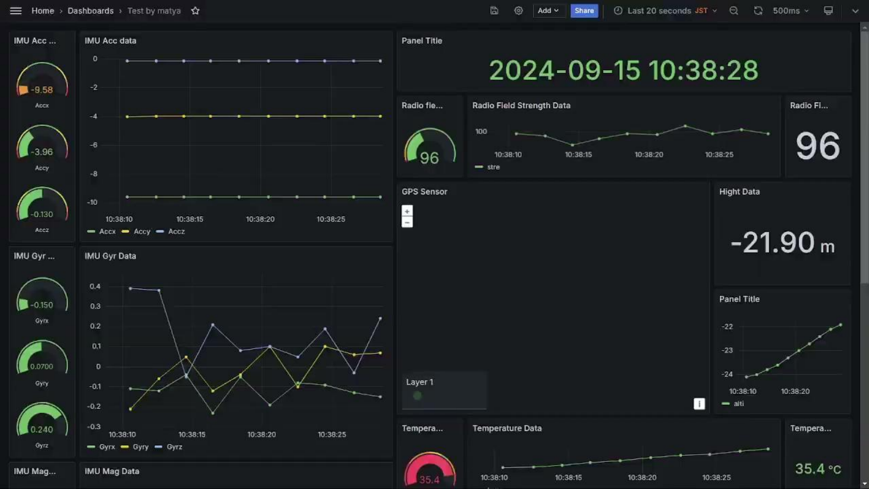
[picture p46: page 30]

CONTENT 01 ミッションに必要な3つの軸 Vision for the 'CanSat Koshien' and the World

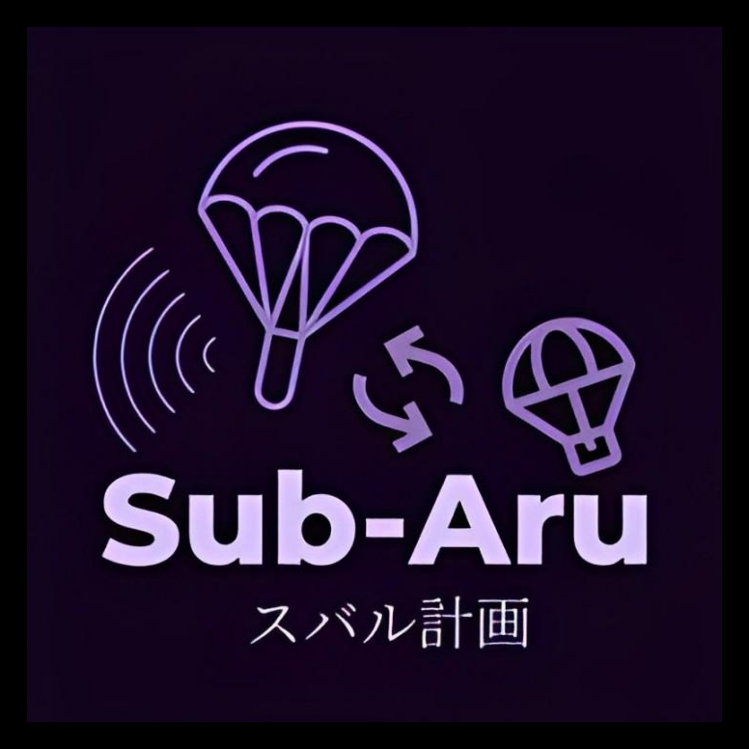
[picture p47: figure]

【mounted the child unit with a parachute】

To prevent entanglement between the child unit and the parent unit, place a parachute between them

CONTENT 01 ミッションに必要な3つの軸 Vision for the 'CanSat Koshien' and the World

Web application for satellite telemetry

## Thank you for listening!

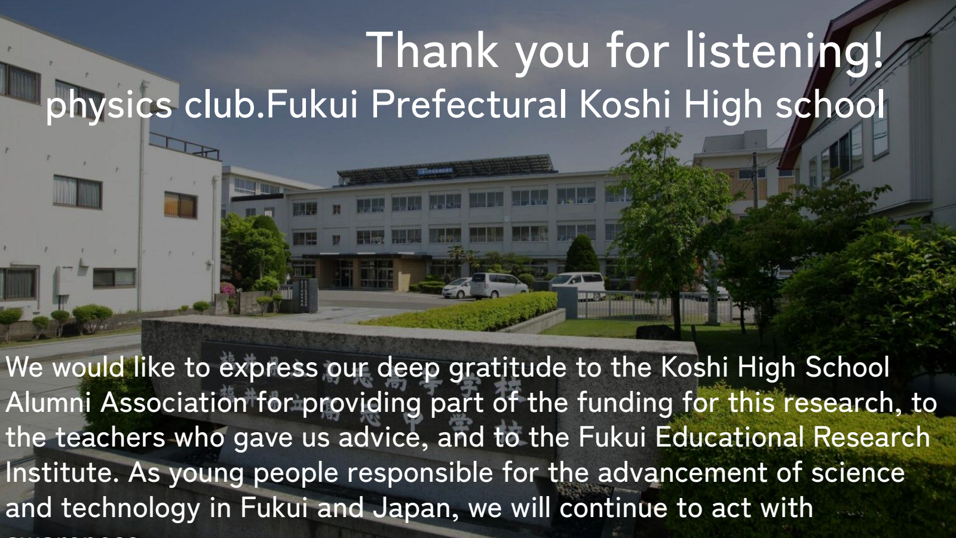
[picture p48: page 33]

physics club.Fukui Prefectural Koshi High school

We would like to express our deep gratitude to the Koshi High School Alumni Association for providing part of the funding for this research, to the teachers who gave us advice, and to the Fukui Educational Research Institute. As young people responsible for the advancement of science and technology in Fukui and Japan, we will continue to act with awareness.

・学校の端、１８０ｍ、届く
Horizon
https://mono-wireless.com/jp/products/TWE-ANTENNAS/wire/index.html (https://mono-wireless.com/jp/products/TWE-ANTENNAS/wire/index.html)
ワイヤアンテナ

meno

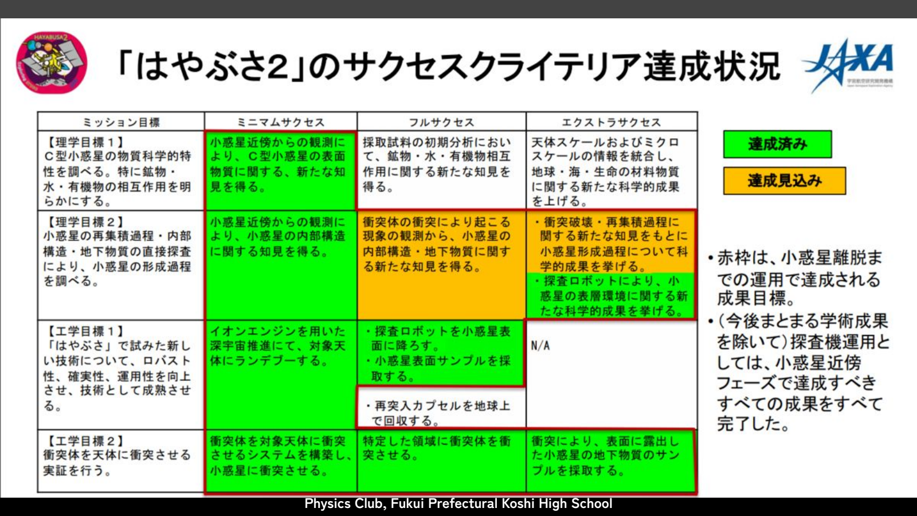
[picture p49: page 35]
