syurecat/cansat-2024/Dashboards/Readme.md

# 注意

- ここにあるDashbordを反映させたい場合はGrafanaにimportで入れる。
- また、基本的にここのjsonファイルを編集しているがimportしなおさないとgrafanaに反映されないので注意。
- なおimportした後に一旦全てのVisualizationの編集画面を開いて戻り、セーブしないとうまく機能しない。
