syurecat/cansat-2024/docs/PresentationPoster.pdf

## 模擬人工衛星の親機子機間の通信技術の確立

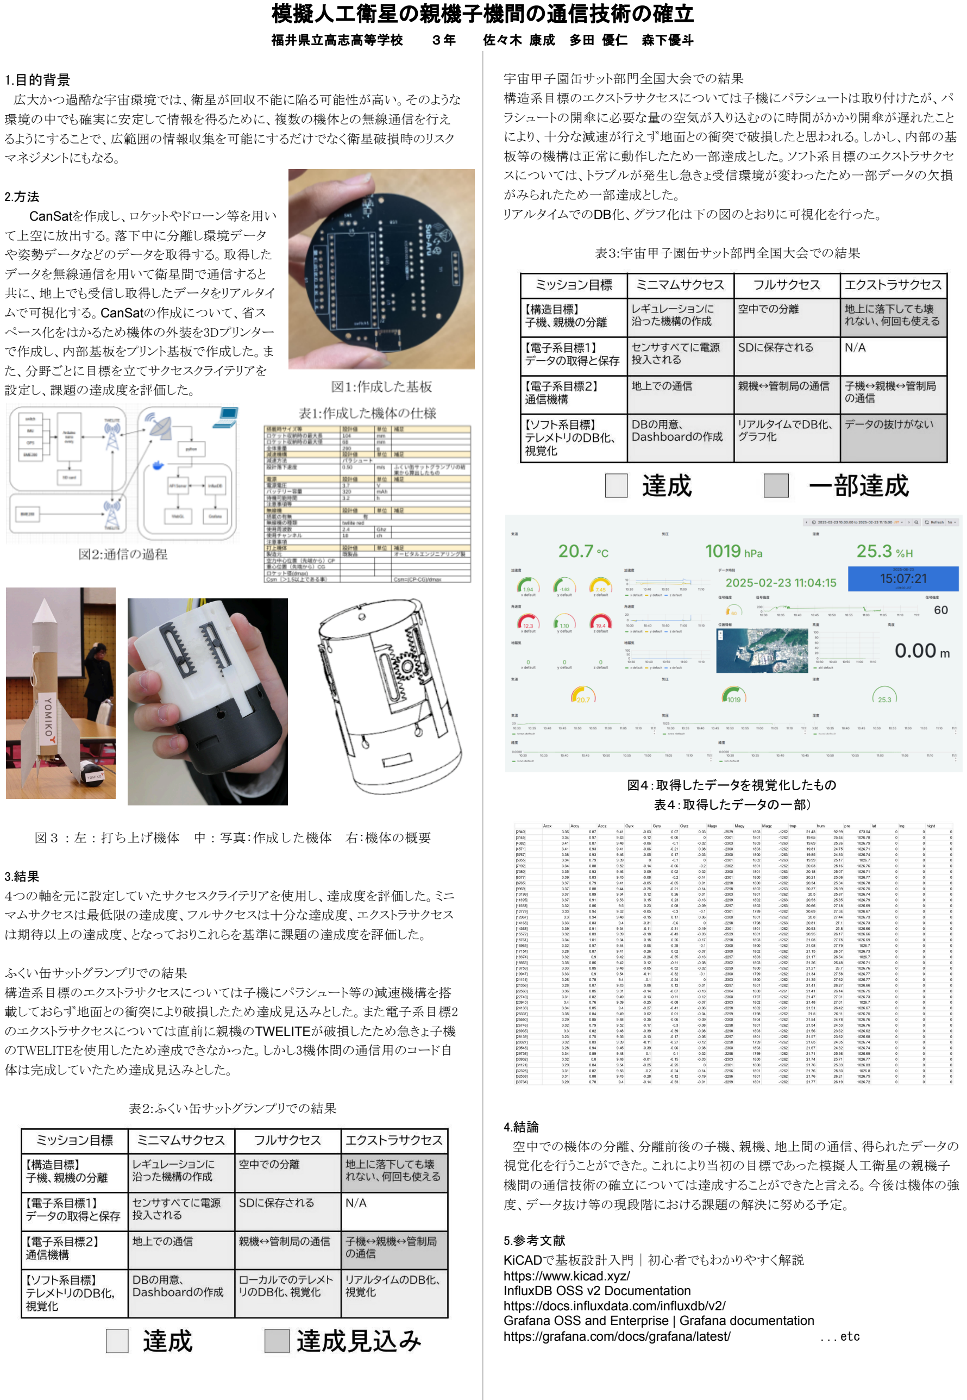
[picture p63: page 1]

福井県立高志高等学校 | ３年 | 佐々木 康成 多田 優仁 森下優斗

1.目的背景
広大かつ過酷な宇宙環境では、衛星が回収不能に陥る可能性が高い。そのような 環境の中でも確実に安定して情報を得るために、複数の機体との無線通信を行え るようにすることで、広範囲の情報収集を可能にするだけでなく衛星破損時のリスク マネジメントにもなる。

2.方法
CanSatを作成し、ロケットやドローン等を用い
て上空に放出する。落下中に分離し環境データ
や姿勢データなどのデータを取得する。取得した
データを無線通信を用いて衛星間で通信すると
共に、地上でも受信し取得したデータをリアルタイ
ムで可視化する。CanSatの作成について、省ス
ペース化をはかるため機体の外装を3Dプリンター
で作成し、内部基板をプリント基板で作成した。ま
た、分野ごとに目標を立てサクセスクライテリアを
設定し、課題の達成度を評価した。

図３：左：打ち上げ機体 中：写真:作成した機体 右:機体の概要

3.結果
４つの軸を元に設定していたサクセスクライテリアを使用し、達成度を評価した。ミニ マムサクセスは最低限の達成度、フルサクセスは十分な達成度、エクストラサクセス は期待以上の達成度、となっておりこれらを基準に課題の達成度を評価した。

ふくい缶サットグランプリでの結果
構造系目標のエクストラサクセスについては子機にパラシュート等の減速機構を搭 載しておらず地面との衝突により破損したため達成見込みとした。また電子系目標2 のエクストラサクセスについては直前に親機のTWELITEが破損したため急きょ子機 のTWELITEを使用したため達成できなかった。しかし3機体間の通信用のコード自 体は完成していたため達成見込みとした。

表２:ふくい缶サットグランプリでの結果

宇宙甲子園缶サット部門全国大会での結果
構造系目標のエクストラサクセスについては子機にパラシュートは取り付けたが、パ ラシュートの開傘に必要な量の空気が入り込むのに時間がかかり開傘が遅れたこと により、十分な減速が行えず地面との衝突で破損したと思われる。しかし、内部の基 板等の機構は正常に動作したため一部達成とした。ソフト系目標のエクストラサクセ スについては、トラブルが発生し急きょ受信環境が変わったため一部データの欠損 がみられたため一部達成とした。
リアルタイムでのDB化、グラフ化は下の図のとおりに可視化を行った。

表３:宇宙甲子園缶サット部門全国大会での結果

図４：取得したデータを視覚化したもの
表４：取得したデータの一部)

4.結論
空中での機体の分離、分離前後の子機、親機、地上間の通信、得られたデータの 視覚化を行うことができた。これにより当初の目標であった模擬人工衛星の親機子 機間の通信技術の確立については達成することができたと言える。今後は機体の強 度、データ抜け等の現段階における課題の解決に努める予定。

5.参考文献
KiCADで基板設計入門｜初心者でもわかりやすく解説 https://www.kicad.xyz/
InfluxDB OSS v2 Documentation https://docs.influxdata.com/influxdb/v2/
Grafana OSS and Enterprise | Grafana documentation
https://grafana.com/docs/grafana/latest/ | ...etc
