syurecat/cansat-2024/docs/OldAbstract.pdf

模擬人工衛星の親機子機間の通信技術の確立
多田優仁、森下優斗、佐々木康成

１．研究の背景と目的
広大かつ過酷な宇宙環境では、衛星が回収不能に陥る可能性が高い。そのような環境の中でも確実 に安定して情報を得るために、複数の機体との無線通信を行えるようにすることで、広範囲の情報収集 を可能にするだけでなく衛星破損時のリスクマネジメントにもなる。 また、分野ごとに目標を立てサクセスクライテリア(表1)を作成し、それらを目的とする。

２．方法
cansatを作成し、ロケットやドローン等を使用して飛ばし、データを取得する。無線通信を用いて取得 したデータをリアルタイムで可視化する。

３．結果
ミニマムサクセス・フルサクセスはすべて達成。エクストラサクセスは構造系目標は一部達成。電子系 目標2は未達成。その他エクストラサクセスは達成。

４．考察
子機が破損したのは、子機にパラシュートを搭載していなかったためだと考えられる。プリント基板の 作成によりはんだの人為的ミスが解消されたと考える。

５．結論
現段階ではデータの取得、受信が安定していないため改善が必要。また着地の際に子機が破損した ため、パラシュートの減速機構を搭載する必要がある。フロントエンド・バックエンドに関して、テレメトリへ の親機の姿勢制御の表示を行う予定。

６．参考文献
KiCADで基板設計入門｜初心者でもわかりやすく解説 https://www.kicad.xyz/

７．キーワード
cansat 無線通信 可視化

８．その他

表一

ミッション目標 | ミニマムサクセス | フルサクセス | エクストラサクセス
【構造目標】 子機、親機の分離 | レギュレーションに沿った機構 の作成 | 空中での分離 | 地上に落下しても壊れない、何回も使える
【電子系目標１】 データの取得と保存 | センサすべてに電源投入され る | SDに保存される | N/A
【電子系目標２】 通信機構 | 地上での通信 | 親機↔管制局の通信 | 子機↔親機↔管制局の通信
【ソフト系目標】 データのDB化,視覚 化 | DBの用意、Dashboardの作成 | ローカルでのテレメトリのDB 化、視覚化 | リアルタイムのDB化、 視覚化
