syurecat/cansat-2024/(threads)

Thread 1 (2024-11-18):

Firefoxでimportmapが正常に読み込まれない。

syurecat, 2024-11-18:
## 概要
可視化においてブラウザをFirefox開くとimportmapが機能せず正常に動作しません。Firefoxベースのブラウザでなければほとんど動作します。
- 早急に対応する必要はありません
- 方法が思いつき次第追記をお願いします

コンソールに出たエラーメッセージは以下の通りです。
```
Uncaught TypeError: specifier “three” は露出していますが、どこにも再マップされていません。モジュール指定の相対パスは “./” または “../”, “/” のいずれかで始まらなければなりません。
```

syurecat, 2025-07-13:
修正は可能ですが、大規模な回収が必要です
そもそも、現在使用しているimport方式がFirefoxでは対応されていないようです

Thread 10 (2025-02-04):

GPSの取得データについて

syurecat, 2025-02-04:
## GPSの取得データについて

### 概要
GPSの取得データを高度にするか速度にするかについて決めかねています。手助けを求めます。

matya415, 2025-02-04:
個人的には高度より速度のほうがいいと思います。
高度がどうしても欲しいって言うなら速度積分して参考値程度に表示すればよいのでは..,?

syurecat, 2025-07-13:
結局高度を取得しています。
修正も考えられますが、現状はこのままです

Closed 2025-07-13.

Thread 6 (2025-02-04):

treejsでの表示を滑らかに

syurecat, 2025-02-04:
## treejsでの表示を滑らかに

### 概要
現在のプログラムでは、センサーの更新レートが遅い場合、表示が滑らかではなくなってしまう。

### すること
アルゴリズムを修正し滑らかにする。

syurecat, 2025-07-13:
ある程度埋めるように実装しましたが、もっと良い修正方法はあるかもしれません。
せんさーの間隔が狭すぎるのと、動きが激しすぎるという問題もあります

Closed 2025-07-13.

Thread 8 (2025-02-04):

分離アニメーションの実装

syurecat, 2025-02-04:
## 分離アニメーションの実装

### 概要
tree.jsでアニメーションを実装できることがわかりました。分離検知を用いて分離アニメーションを実装したいです。

### 提案
- アニメーションの作成
- tree.jsでのアニメーションのレンダリング
- webSocketで分離のシグナルを送信。
