syurecat/cansat-2024/docs/blueprint.pdf

### Part_list

name | required
main_body | 1
sub_body | 1
connection_parts | 3
gear | 3
gear_parts | 3
rack | 6
rack_parts | 6
swich_connect_parts | 1

2

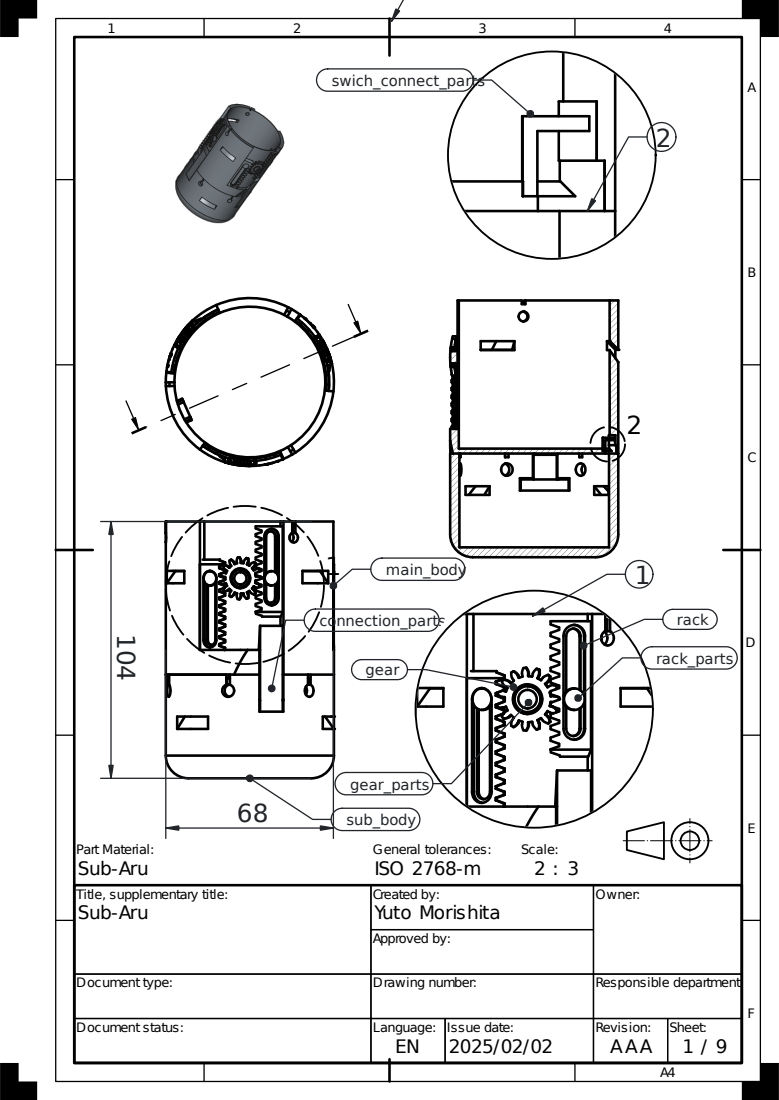
[picture p69: page 2]
Owner:; Drawing number:; Language: Issue date:; Revision: Sheet:; Responsible department:; Approved by:; Created by:; Document type:; Document status:; Part Material:; General tolerances:; Scale:; 1 / 9 AAA; Sub-Aru; Yuto Morishita; ISO 2768-m; main_body; sub_body; connection_parts; swich_connect_parts; rack_parts; rack; gear_parts; gear

Title, supplementary title:

1
1

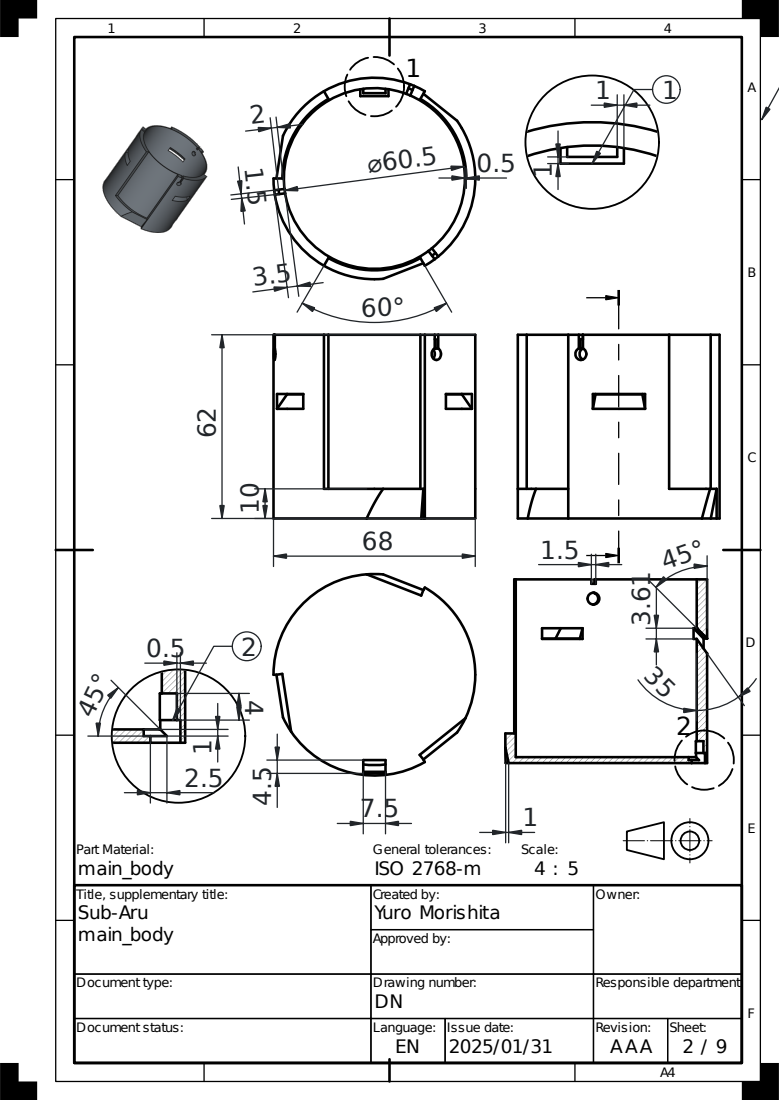
[picture p70: page 3]
Owner:; Drawing number:; Responsible department:; Approved by:; Created by:; Document type:; Part Material:; General tolerances:; Scale:; 2 / 9 AAA; Yuro Morishita; main_body; ISO 2768-m

Title, supplementary title:
Sub-Aru
main_body

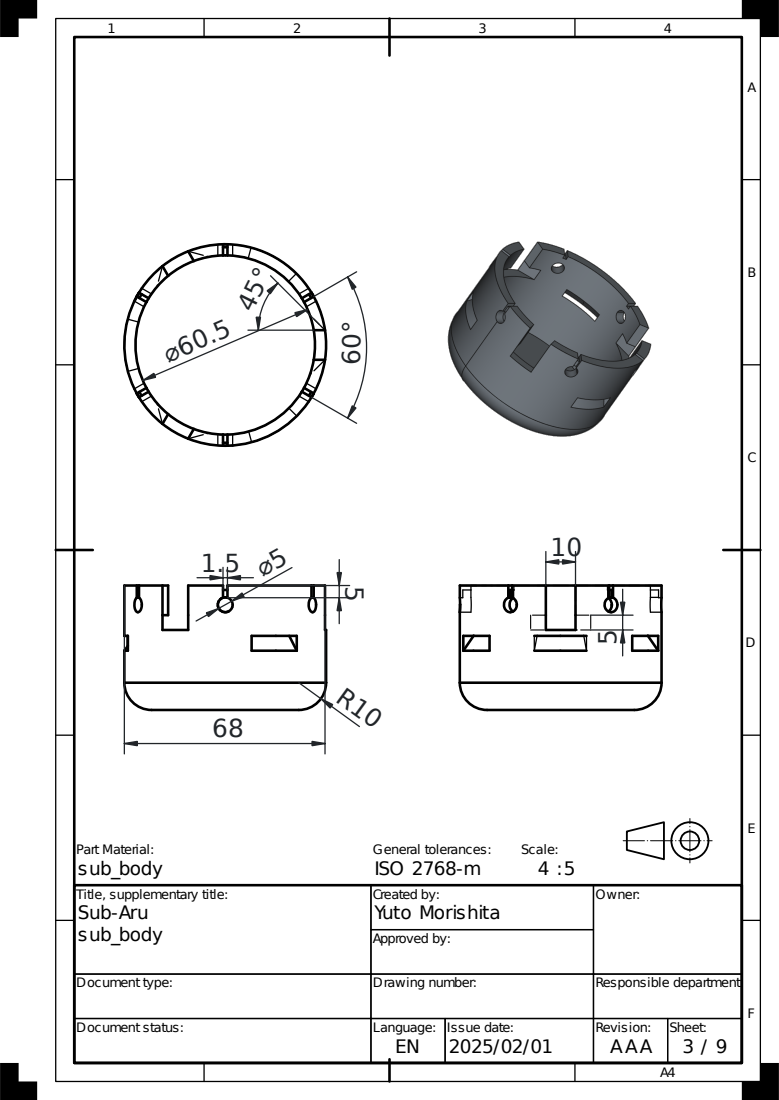
[picture p71: page 4]
Owner:; Drawing number:; Responsible department:; Approved by:; Created by:; Document type:; Part Material:; General tolerances:; Scale:; 3 / 9 AAA; Yuto Morishita; sub_body; ISO 2768-m

Title, supplementary title:
Sub-Aru
sub_body

9.5

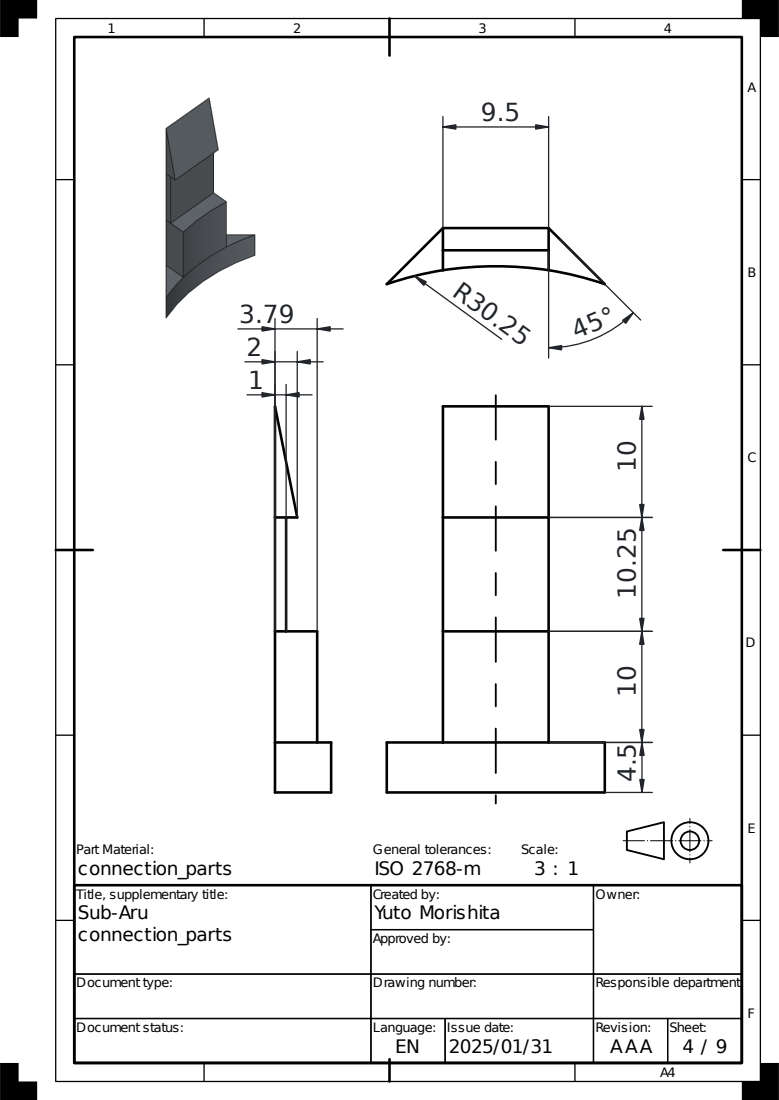
[picture p72: page 5]
Owner:; Drawing number:; Responsible department:; Approved by:; Created by:; Document type:; Part Material:; General tolerances:; Scale:; 4 / 9 AAA; Yuto Morishita; connection_parts; ISO 2768-m

Title, supplementary title:
Sub-Aru
connection_parts

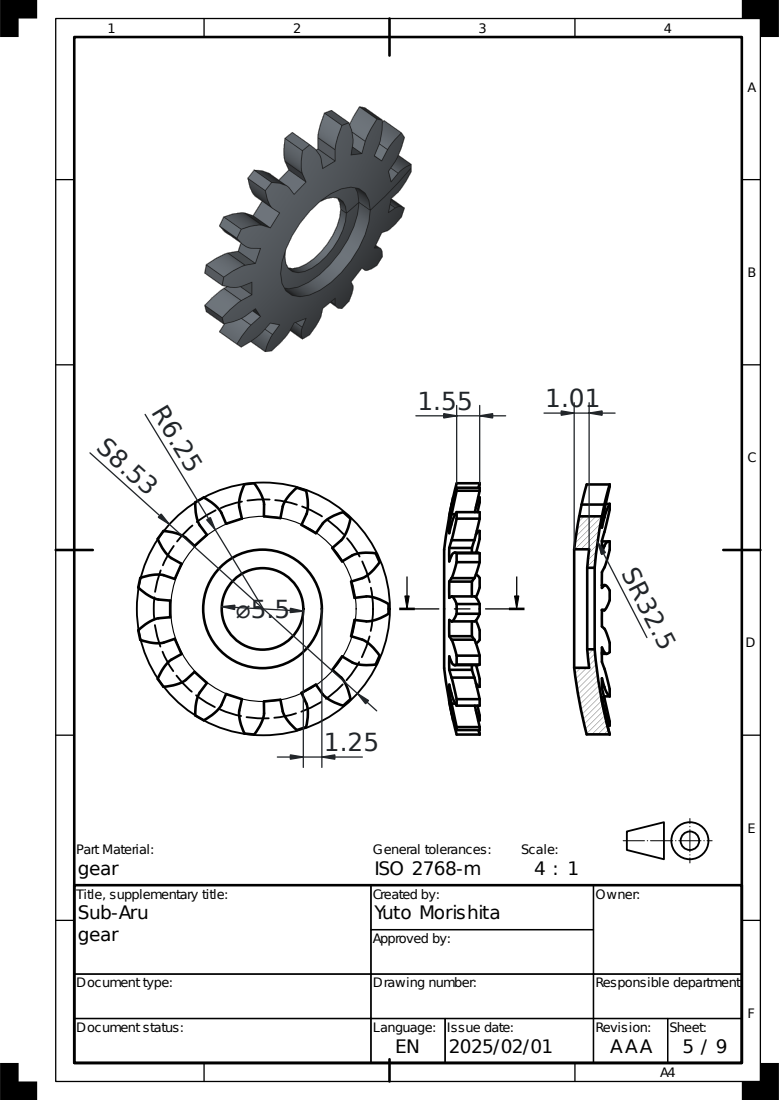
[picture p73: page 6]
Owner:; Drawing number:; Responsible department:; Approved by:; Created by:; Document type:; Part Material:; General tolerances:; Scale:; 5 / 9 AAA; Yuto Morishita; gear; ISO 2768-m

Title, supplementary title:
Sub-Aru
gear

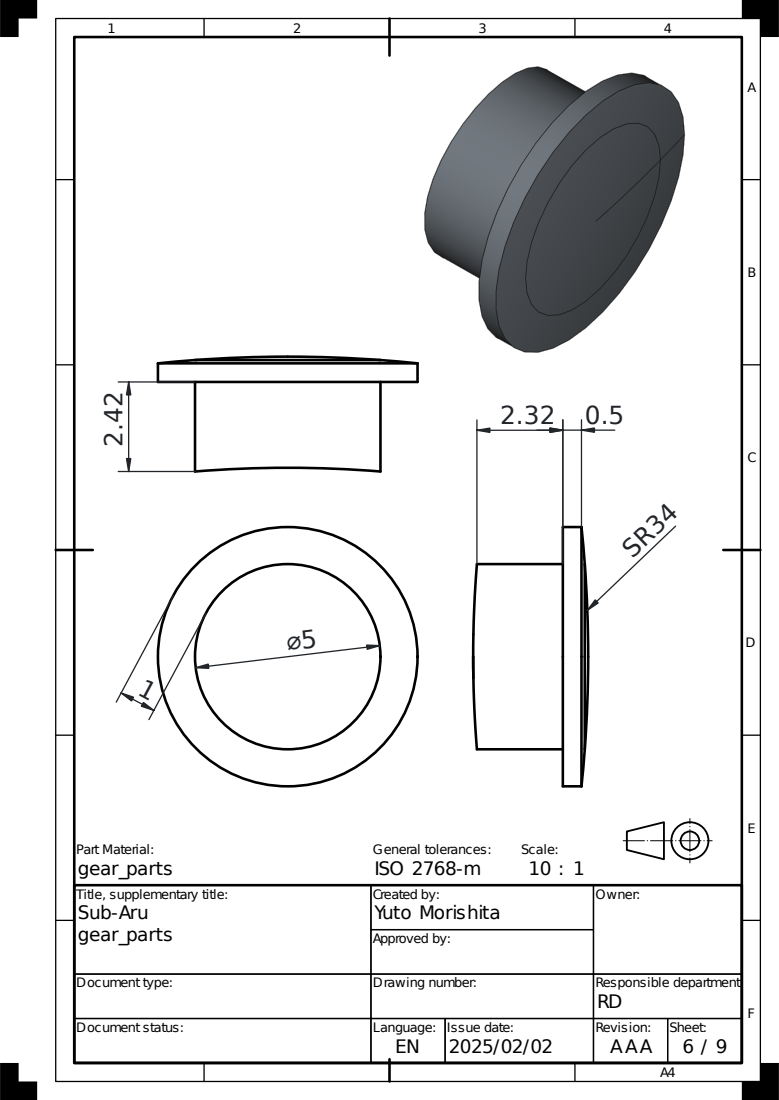
[picture p74: page 7]
Owner:; Drawing number:; Responsible department:; Approved by:; Created by:; Document type:; Part Material:; General tolerances:; Scale:; 6 / 9 AAA; Yuto Morishita; gear_parts; ISO 2768-m

Title, supplementary title:
Sub-Aru
gear_parts

1

1

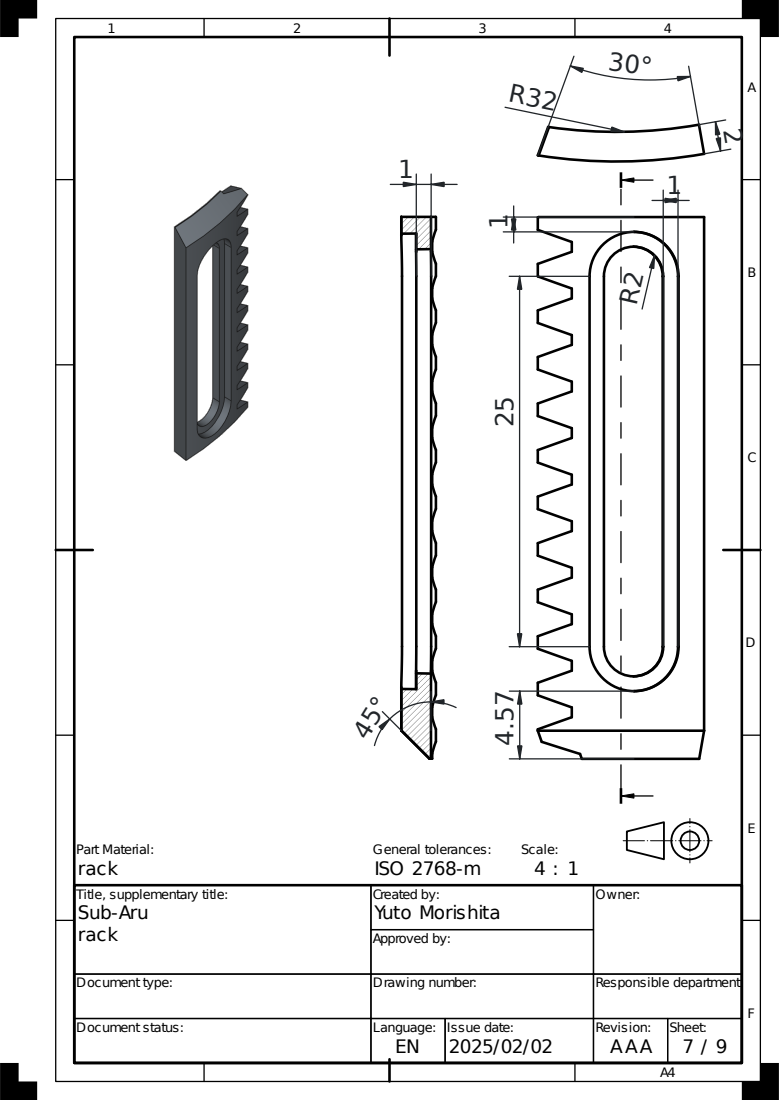
[picture p75: page 8]
Owner:; Drawing number:; Responsible department:; Approved by:; Created by:; Document type:; Part Material:; General tolerances:; Scale:; 7 / 9 AAA; Yuto Morishita; rack; ISO 2768-m

Title, supplementary title:
Sub-Aru
rack

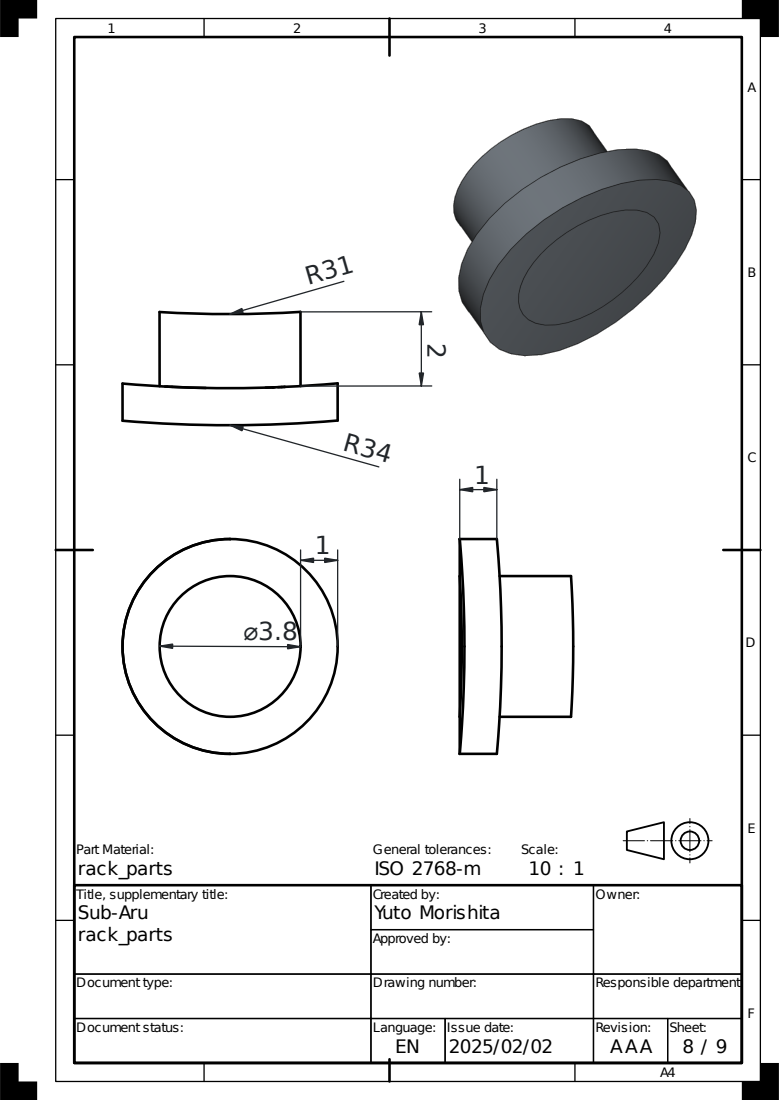
[picture p76: page 9]
Owner:; Drawing number:; Responsible department:; Approved by:; Created by:; Document type:; Part Material:; General tolerances:; Scale:; 8 / 9 AAA; Yuto Morishita; rack_parts; ISO 2768-m

Title, supplementary title:
Sub-Aru
rack_parts

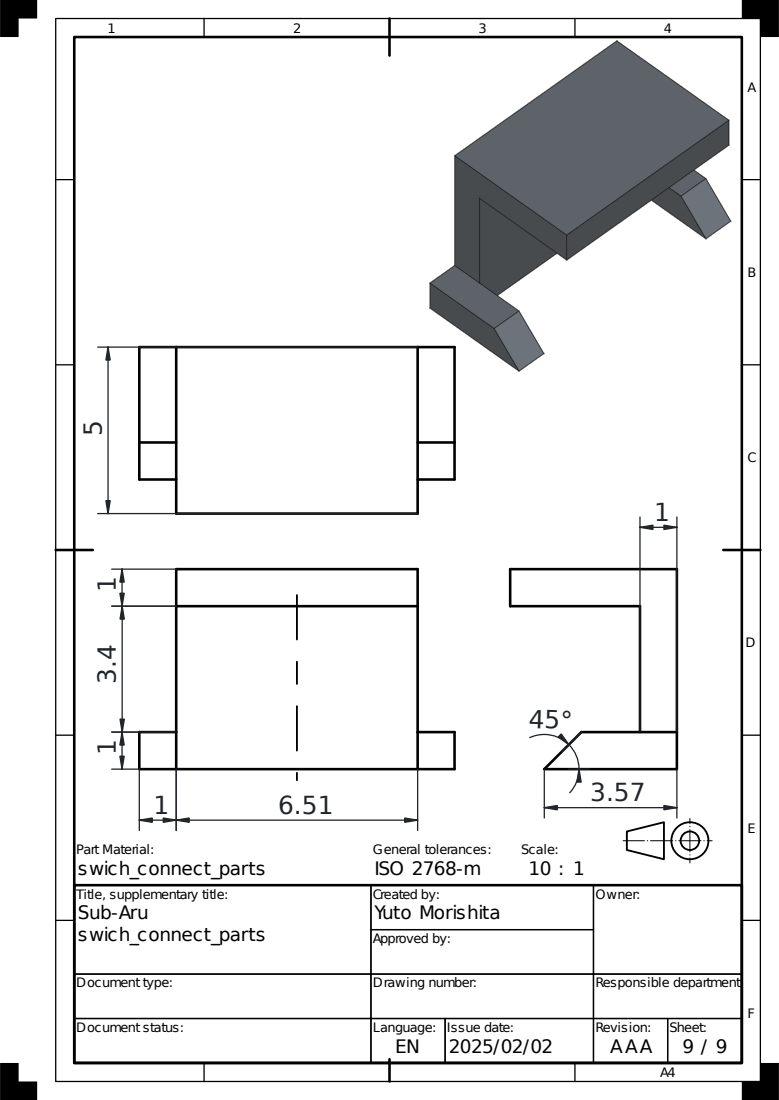
[picture p77: page 10]
Owner:; Drawing number:; Responsible department:; Approved by:; Created by:; Document type:; Part Material:; General tolerances:; Scale:; 9 / 9 AAA; Yuto Morishita; swich_connect_parts; ISO 2768-m

Title, supplementary title:
Sub-Aru
swich_connect_parts
