syurecat/cansat-2024/tests/arduino/arduino/Serial_conversion/Serial_conversion.ino

#include <SoftwareSerial.h>


void setup() {
    Serial.begin(9800);
    Serial1.begin(9800);
    Serial.println("Ready");
}

void loop() {
    if (Serial.available()) {
        char dataFromPC = Serial.read();
        Serial1.write(dataFromPC);
    }

    if (Serial1.available()) {
        char dataFromDevice = Serial1.read();
        Serial.write(dataFromDevice);
    }
}
