syurecat/cansat-2024/(commit log)

2024-06-15 add arduino
2024-06-15 modified: arduino/main/main.ino
2024-11-20 test - change camera potision
2024-12-11 add LED debag
2024-12-14 add LED states
2024-12-17 add led states for main loop
2024-12-27 add pin assign led
2024-12-27 add blink led Init
2024-12-27 add main led init
2024-12-27 add bme led error
    [BarometerThermohygrometer.h, BarometerThermohygrometer.ino]
2024-12-27 add error led flag
    [SD.h, SD.ino, main.ino]
2024-12-27 add pin assign
2025-01-17 add test led
2025-02-02 fix IMU calculator
2025-02-16 fix imucalculator
2025-02-16 update imu
2025-02-16 deleted frame
2025-02-20 parent development
